huynguyen2311179-ui/STM32-PLC/01_Full_Design/Project Outputs for DA1_prj/DA1_prj.xlsx

Line # | Name | Description | Designator | Revision ID | Revision State | Revision Status | Quantity | Footprint | Manufacturer 1 | Manufacturer Part Number 1 | Manufacturer Lifecycle 1 | Supplier 1 | Supplier Part Number 1 | Supplier Unit Price 1 | Supplier Subtotal 1
 | 3002 | Battery Holder: SMT, 1 Coin Cell, 20mm, PhosBronze/Tin-Nickel | Keystone Electronics 3002 | BT1 |  | Not managed |  | 1 | BAT_3002
 | 100nF | Capacitor (Semiconductor SIM Model) | C1, C2, C4, C5, C7, C8, C25, C33, C34, C35, C36 |  | Not managed |  | 11 | FP-C0603C-CF-IPC_A
 | 4.7uF | Capacitor (Semiconductor SIM Model) | C3, C6, C9 |  | Not managed |  | 3 | FP-C0603C-CF-IPC_A
 | 1uF | Capacitor (Semiconductor SIM Model) | C10, C11, C15, C17, C19, C21, C23 |  | Not managed |  | 7 | FP-C0603C-CF-IPC_A
 | 10pF | Capacitor (Semiconductor SIM Model) | C12, C24 |  | Not managed |  | 2 | FP-C0603C-CF-IPC_A
 | 4,7pF | Capacitor (Semiconductor SIM Model) | C13, C26 |  | Not managed |  | 2 | FP-C0603C-CF-IPC_A
 | 10nF | Capacitor (Semiconductor SIM Model) | C14, C16, C18, C20, C22, C27, C28, C29, C30, C31, C32 |  | Not managed |  | 11 | FP-C0603C-CF-IPC_A
 | PESD5V0L2BT,215 |  | D1 |  | Not managed |  | 1 | SOT95P230X110-3N
 | BZX84C3V6LT1G |  | D2, D3, D4, D5, D6, D7, D8, D9, D10, D11, D12, D13, D14, D15, D16, D17, D18, D19, D20, D21, D22, D23 |  | Not managed |  | 22 | SOT95P240X111-3N
 | B560C-13-F | Diode Schottky 60 V 5A Surface Mount SMC | D24 |  | Not managed |  | 1 | SMC
 | LED_USB_RX_TX | 430mcd Colorless transparence 520nm Emerald 140° LED0603 Light Emitting Diodes (LED) ROHS | D25 |  | Not managed |  | 1 | WL-SMCW_0603_150060xx75000
 | LED_CAN_RX_TX | 430mcd Colorless transparence 520nm Emerald 140° LED0603 Light Emitting Diodes (LED) ROHS | D26 |  | Not managed |  | 1 | WL-SMCW_0603_150060xx75000
 | LED_ERROR | 430mcd Colorless transparence 520nm Emerald 140° LED0603 Light Emitting Diodes (LED) ROHS | D27 |  | Not managed |  | 1 | WL-SMCW_0603_150060xx75000
 | 0ZCH0150FF2E | 1210 SMT PPTC | 1.50 Ih | 6V | F1, F2, F3, F4, F5, F6, F7, F8, F9, F10, F11, F12, F13, F14, F15, F16, F17, F18, F19, F20, F21, F22, F23, F24, F25, F26, F27, F28, F29, F30 |  | Not managed |  | 30 | FUSC3225X90N
 | MountingHole_Pad |  | H1, H2, H3, H4 |  | Not managed |  | 4 | MountingHole_2.7mm_M2.5_DIN965_Pad
 | JP8 | Connector 8 | JP1 |  | Not managed |  | 1 | HDR/Header/8
 | Screw_terminal 1x6 | Header, 6-Pin | P1 |  | Not managed |  | 1 | HDR/Terminal/6
 | _x0016_Screw_terminal 1x6 | Header, 6-Pin | P2, P3, P6, P7, P8, P11 |  | Not managed |  | 6 | HDR/Terminal/6
 | _x0016_Screw_terminal 1x3 | Header, 3-Pin | P4 |  | Not managed |  | 1 | HDR/Terminal/3
 | _x0016_Screw_terminal 1x4 | Header, 4-Pin | P5, P10 |  | Not managed |  | 2 | HDR/Terminal/4
 | _x0016_Screw_terminal 1x2 | Header, 2-Pin | P9, P12 |  | Not managed |  | 2 | HDR/Terminal/2
 | BUK9M15-60EX | Bá»™ chuyá»ƒn Ä‘á»•i N-Channel 60 V 47A (Tc) 75W (Tc) gáº¯n bá» máº·t LFPAK33 | Q1, Q2, Q3, Q4, Q5, Q6, Q7, Q8 |  | Not managed |  | 8 | TRANS_BUK9M15-60EX
 | BC847C-QR |  | Q9, Q10, Q11 |  | Not managed |  | 3 | SOT95P240X111-3N
 | 1,5k | RES | R1 |  | Not managed |  | 1 | tro smd 0603
 | 2k | RES | R2 |  | Not managed |  | 1 | tro smd 0603
 | 0 | RES | R3, R5 |  | Not managed |  | 2 | tro smd 0603
 | 60 | RES | R4, R6 |  | Not managed |  | 2 | tro smd 0603
 | 1k | RES | R7, R8, R9, R10, R11, R12, R13, R14, R15, R16, R17, R18, R19, R20, R21, R22, R23, R24, R25, R26, R63, R64, R65, R66, R67, R68, R69, R70, R71, R72, R73, R74, R75, R76, R77, R78, R79, R80, R81, R82 |  | Not managed |  | 40 | tro smd 0603
 | 160 | RES | R27, R28, R29, R33, R34, R35, R39, R40, R43, R44, R45, R46, R47, R48, R49, R50, R51, R52, R53, R54, R55, R56, R57, R58, R59, R60, R61, R62, R83, R84, R85, R86, R87, R88, R89, R90, R91, R92, R93, R94, R95, R96, R97, R98, R99, R100, R101, R102, R103, R104, R105, R106, R109, R110, R118 |  | Not managed |  | 55 | tro smd 0603
 | 10k | RES | R30, R31, R32, R36, R37, R38, R41, R42, R107, R108, R111, R112, R113, R114, R115, R116, R117, R119, R120, R121 |  | Not managed |  | 20 | tro smd 0603
 | 220 | RES | R122, R123, R124 |  | Not managed |  | 3 | tro smd 0603
 | ST-Link V2 connector | Header, 6-Pin | STLINK2 |  | Not managed |  | 1 | HDR/Header/6
 | SW | Switch button 2 pin | SW1 |  | Not managed |  | 1 | SW1-SMD
 | 4-5435640-1 | SWITCH ROCKER DIP SPST 60MA 5V | SW2 |  | Unknown server |  | 1 | FP-4-5435640-1-MFG
 | MIC5504-3.3YM5_TR | Linear Voltage Regulator IC Positive Fixed 1 Output 300mA SOT-23-5 | U1 |  | Not managed |  | 1 | SOT95P280X145-5N
 | STM32F373VBTx |  | U2 |  | Not managed |  | 1 | QFP50P1600X1600X160-100N
 | TCAN332D | 3.3-V CAN Transceivers | U3 |  | Not managed |  | 1 | SOIC127P599X175-8N
 | PC817X3NSZ1B | Optoisolator Transistor Output - 1 Channel 4-DIP | U4, U5, U6, U7, U8, U9, U10, U11, U12, U13, U14, U15, U16, U17, U18, U19, U20, U21, U22, U23 |  | Not managed |  | 20 | DIP762W50P254L495H455Q4
 | LM324AM | Low power general-purpose quad operational amplifier 14-SOIC 0 to 70 | U24 |  | Not managed |  | 1 | SOIC127P600X175-14N
 | LM2904DR | Dual, 26-V, 700-kHz operational amplifier | U25 |  | Not managed |  | 1 | SOIC127P599X175-8N
 | SN74HC14N | Hex Schmitt-Trigger Inverters, N0014A, TUBE | U26, U27 |  | Unknown server |  | 2 | N0014A
 | USB-B1HSB6 | USB-B (USB TYPE-B) - Receptacle Connector 4 Position Through Hole, Right Angle | X1 |  | Not managed |  | 1 | OST_USB-B1HSB6
 | HSE | Crystal For all Crystal 2pin. | X2 |  | Not managed |  | 1 | XT3
 | LSE | 32.768 kHz Â±20ppm Crystal 7pF 70 kOhms 2-SMD, No Lead | Y1 |  | Not managed |  | 1 | XTAL_ECS-.327-7-34B-TR
