huynguyen2311179-ui/STM32-PLC/01_Full_Design/DA1_prj.pdf

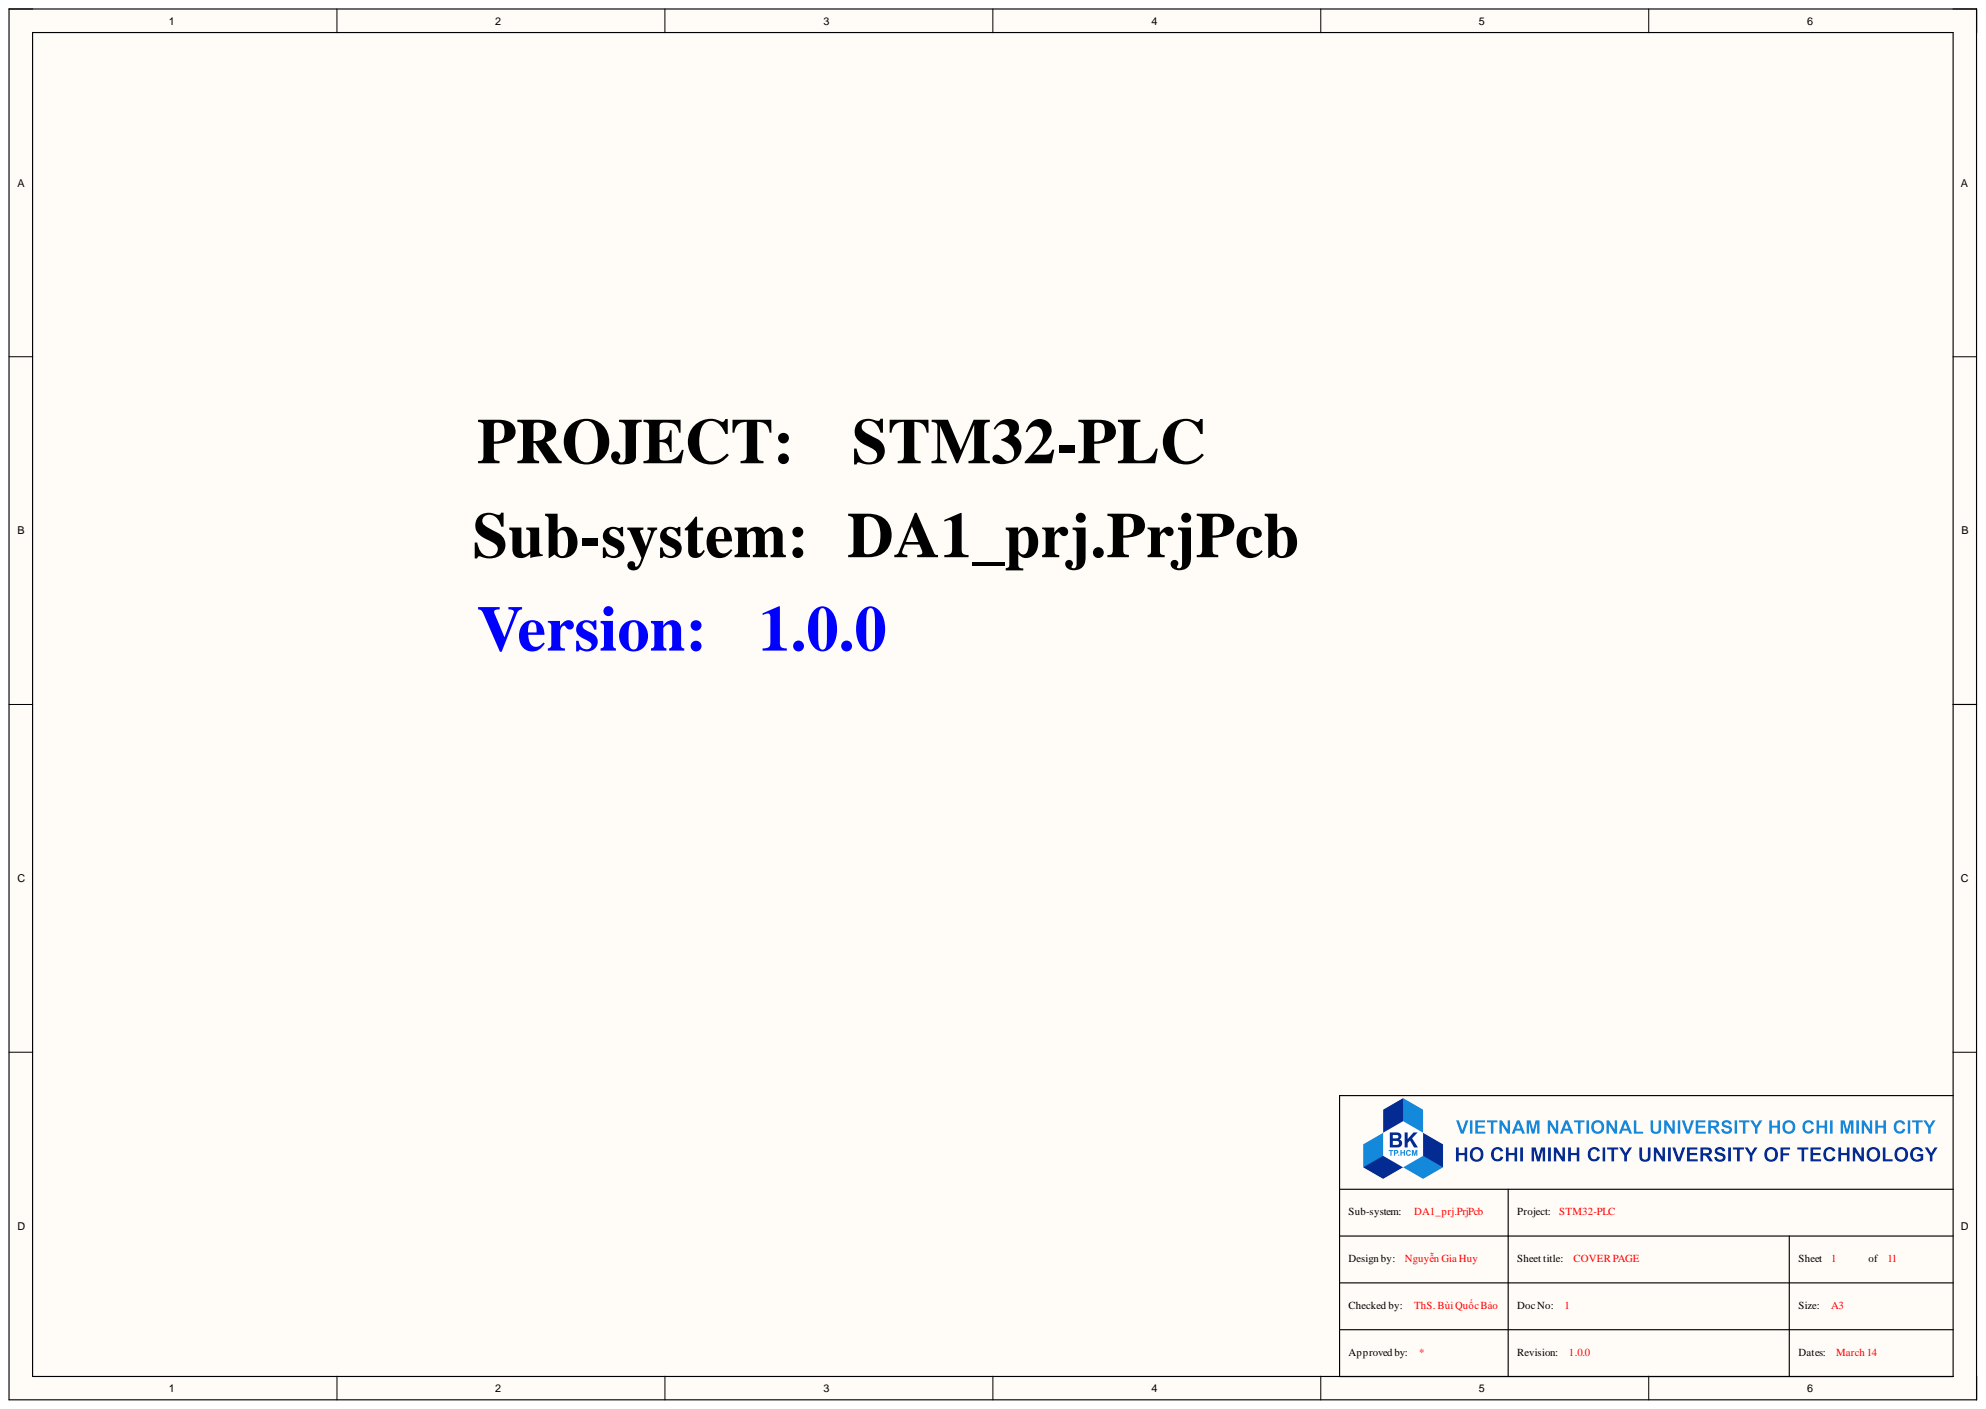
[picture p37: page 1]

Sub-system: DA1_prj.PrjPcb | Project: STM32-PLC

Design by: Nguyễn Gia Huy | Sheet title: COVER PAGE | Sheet 1 of 11

ThS. BùiQuốcBảo Checked by: | DocNo: | Size: A3

Approved by: * | Revision: 1.0.0 | Dates: March 14

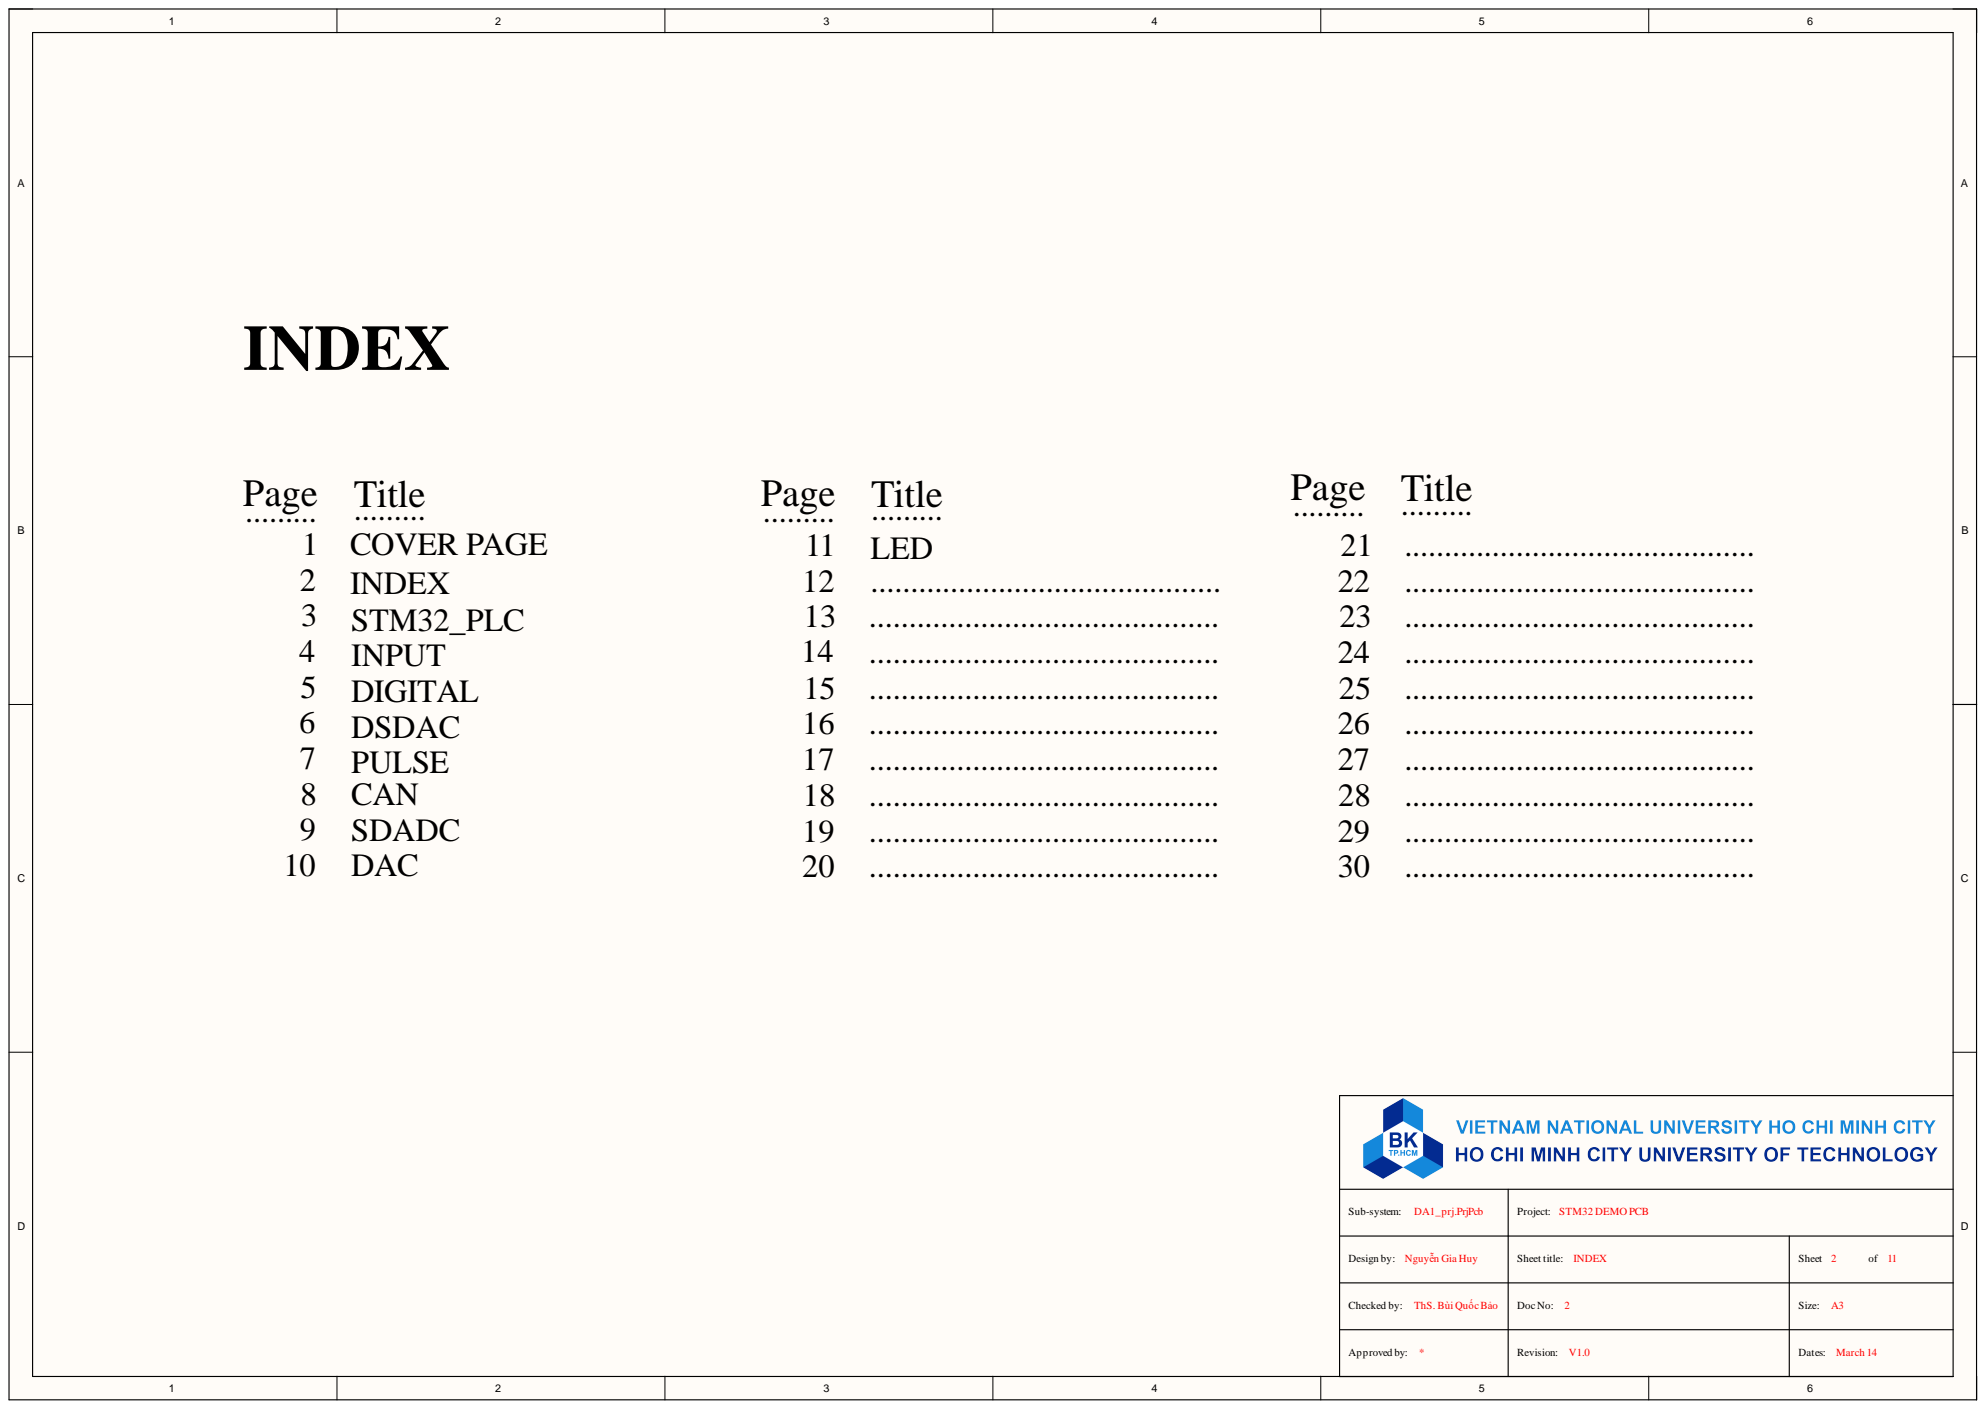
[picture p38: page 2]

Sub-system: DA1_prj.PrjPcb | Project: STM32 DEMO PCB

Design by: Nguyễn Gia Huy | Sheet title: INDEX | Sheet 2 of 11

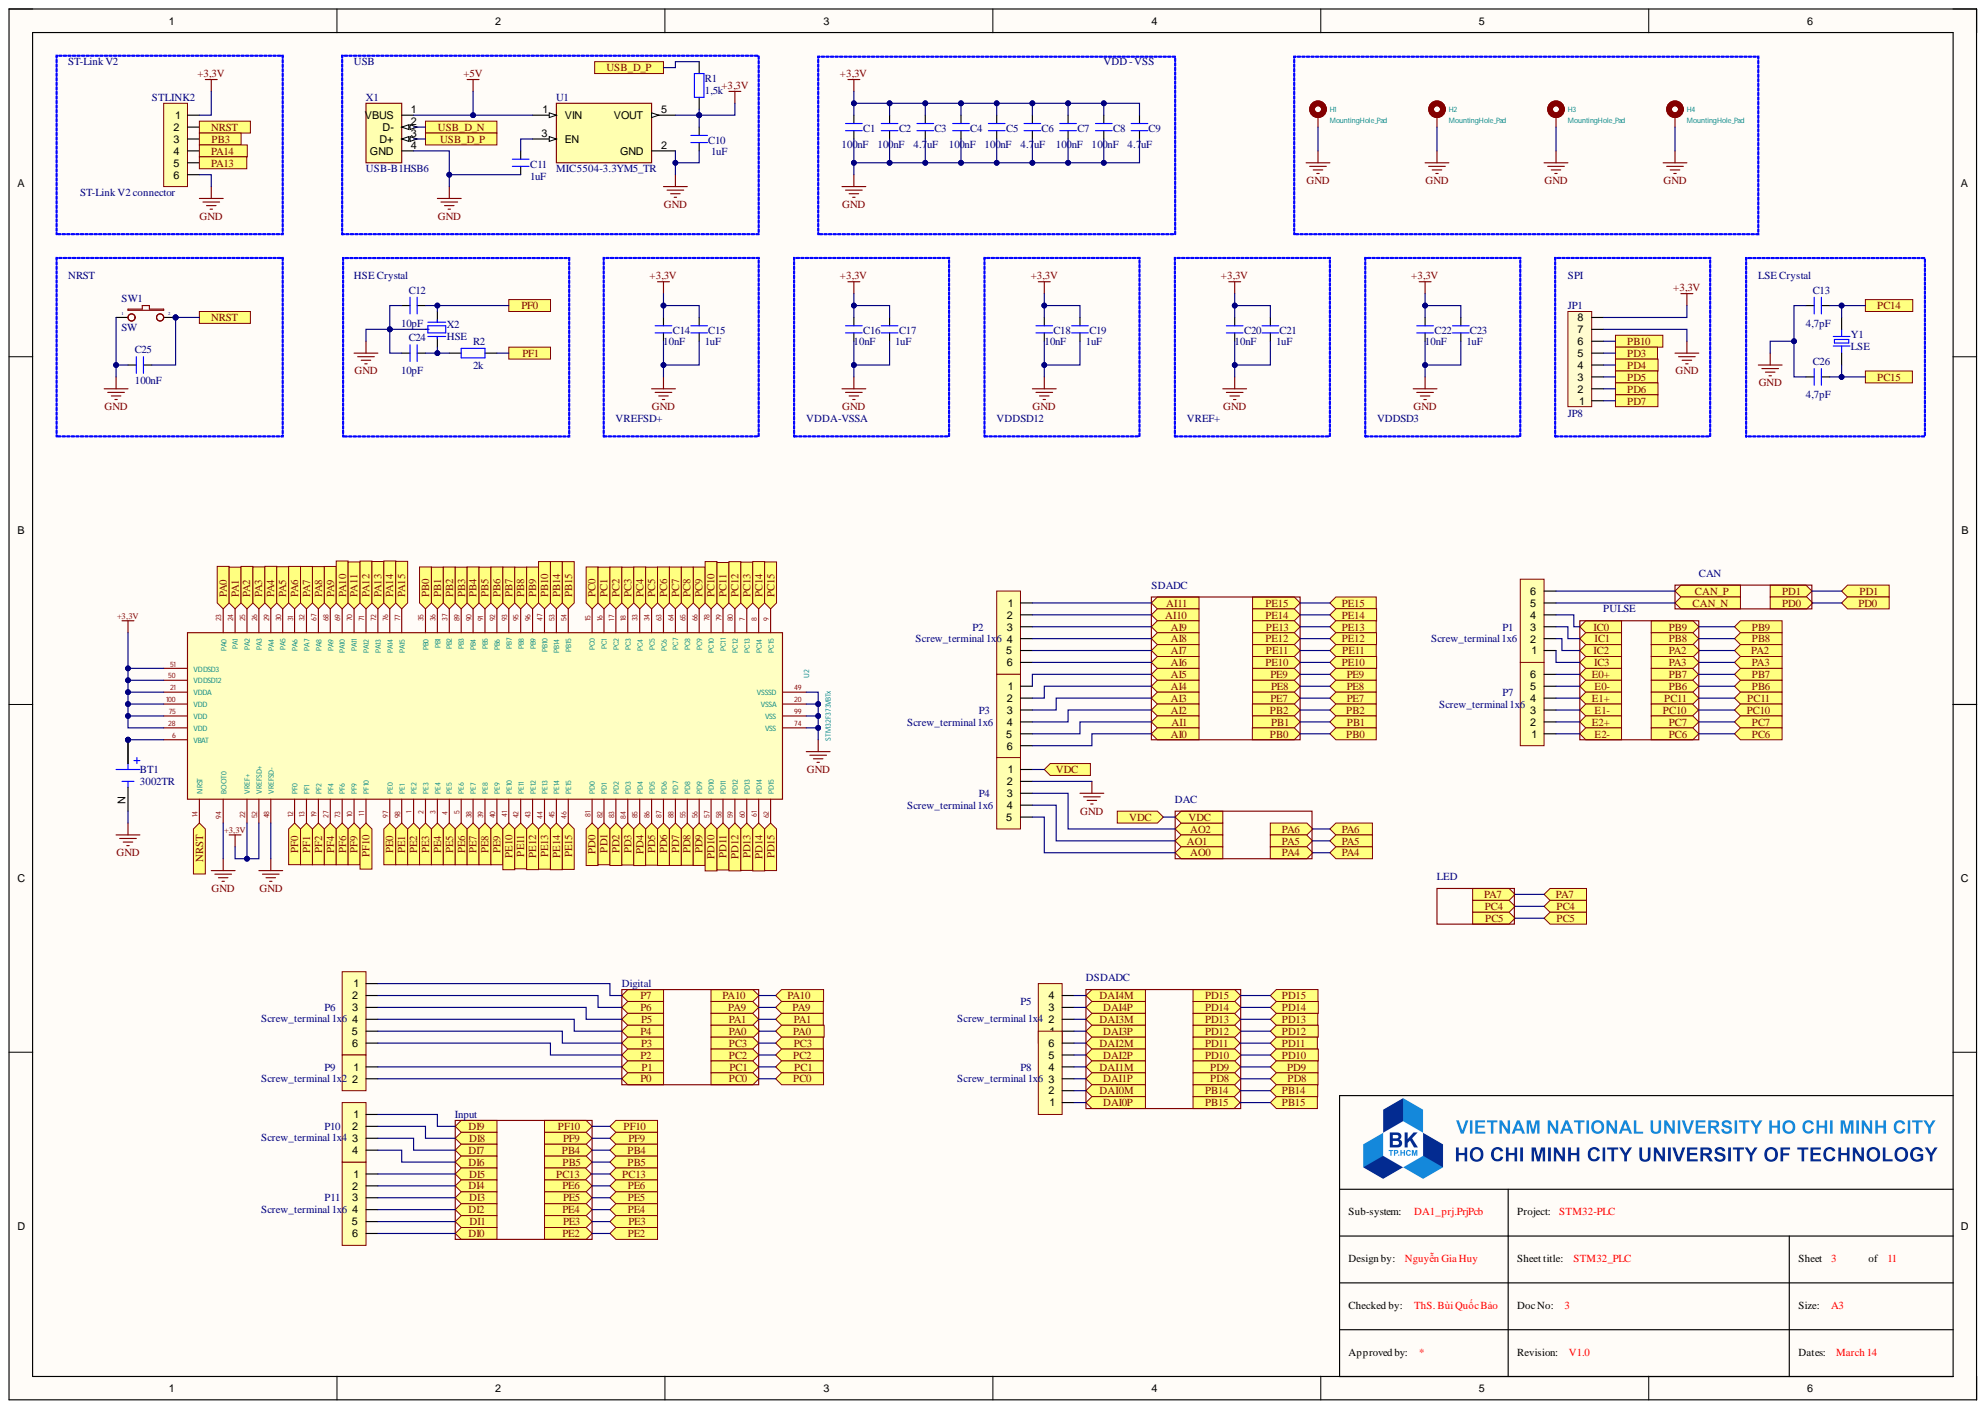
[picture p39: page 3]

VDC | VDC GND AO2 PA6 AO1 PA5 AO0 PA4

5 4 3 2 1

Sub-system: DA1_prj.PrjPcb | Project: STM32-PLC

Design by: Nguyễn Gia Huy | Sheet title: STM32_PLC | Sheet 3 of 11

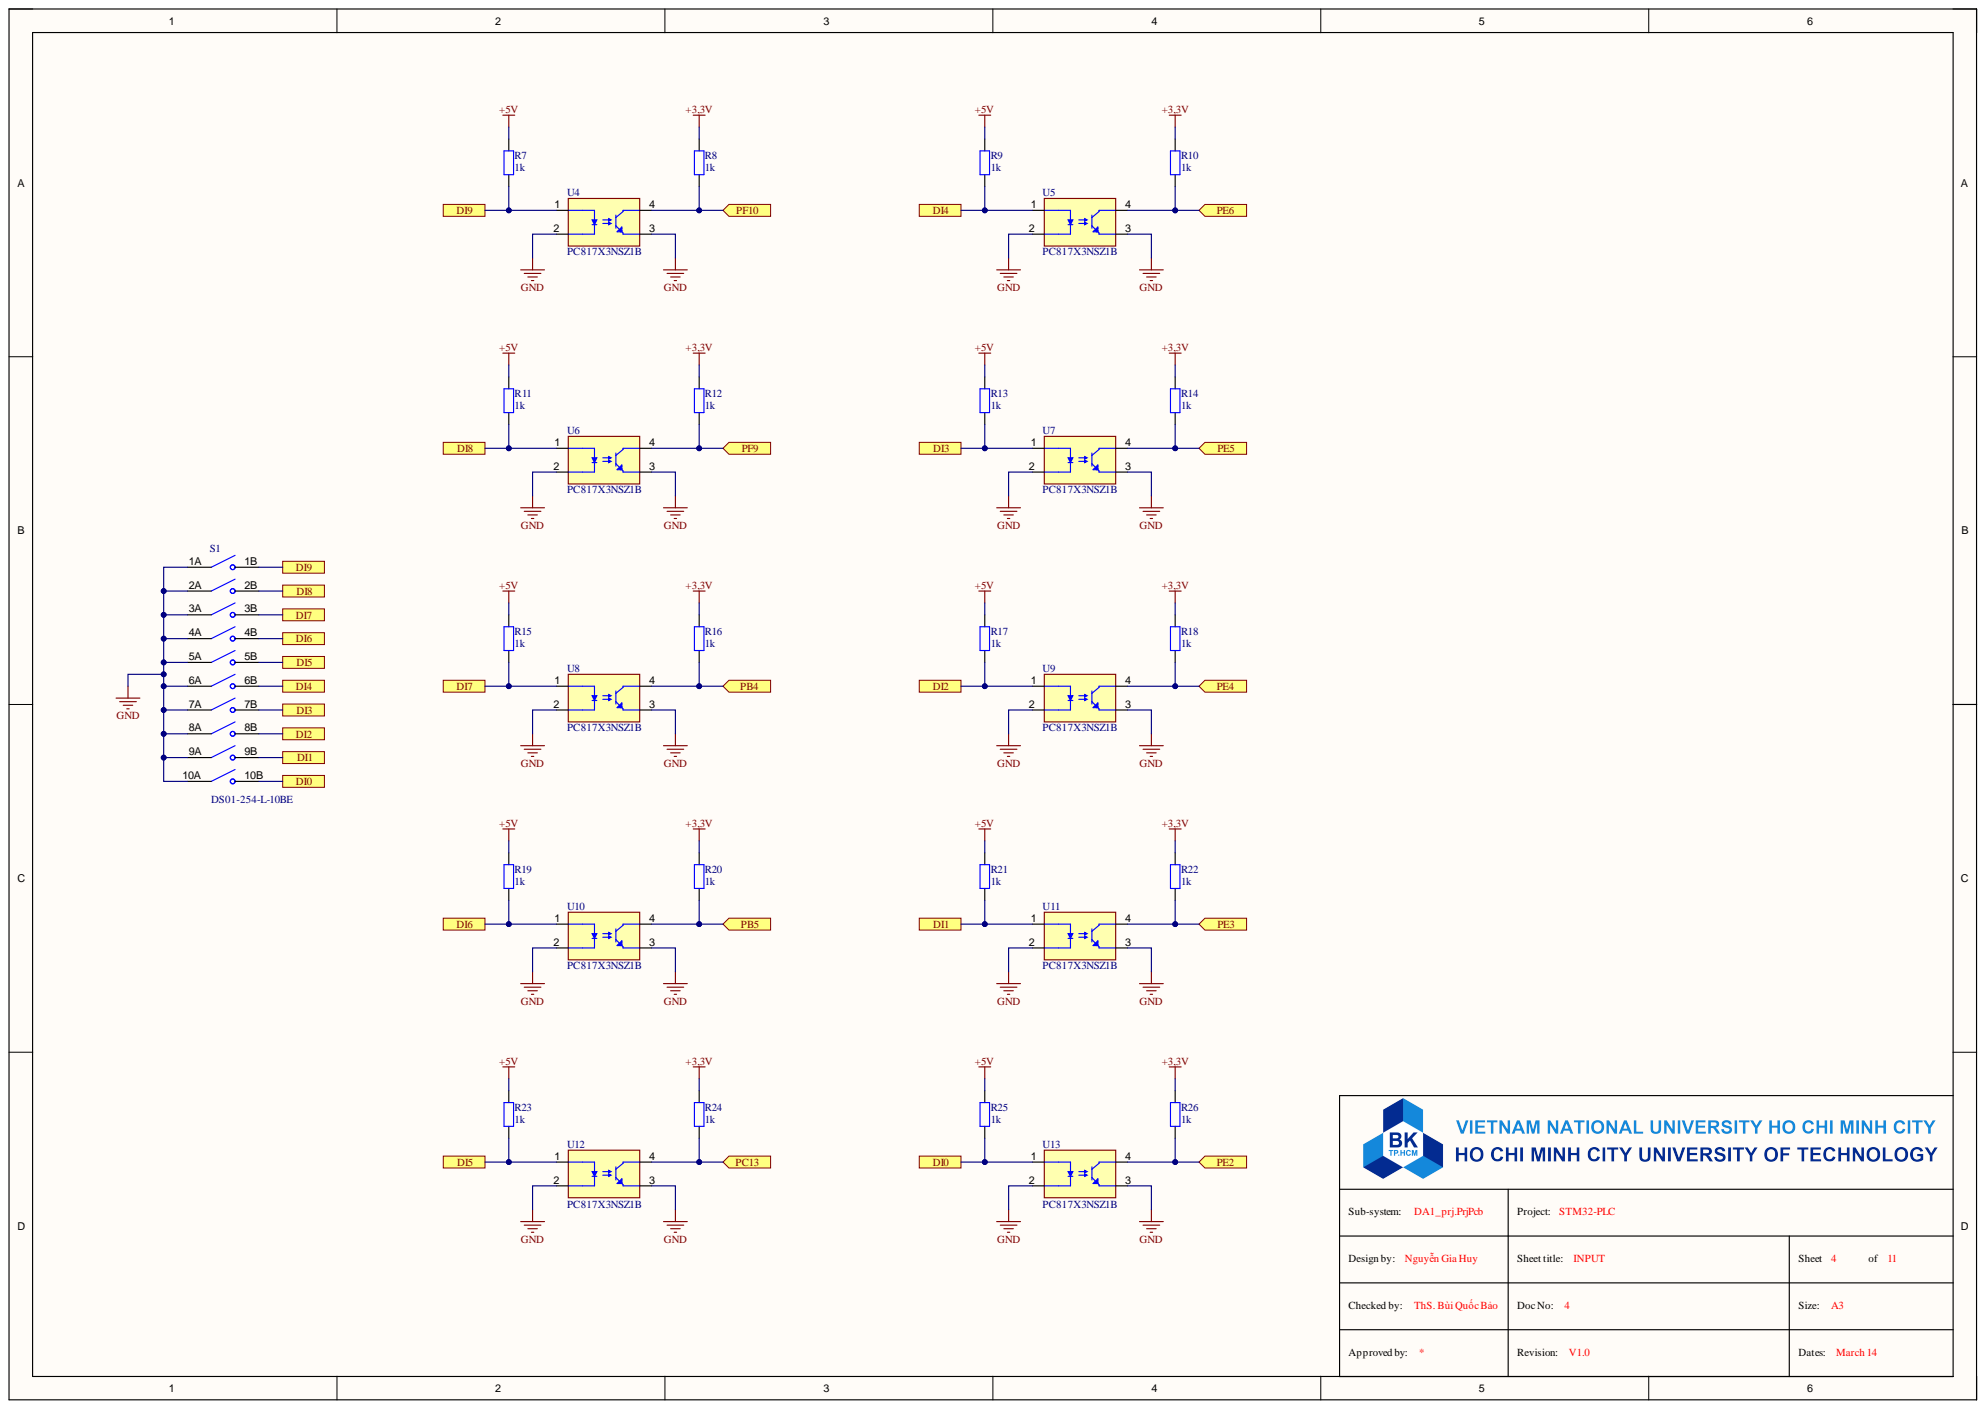
[picture p40: page 4]

Sub-system: DA1_prj.PrjPcb | Project: STM32-PLC

Design by: Nguyễn Gia Huy | Sheet title: INPUT | Sheet 4 of 11

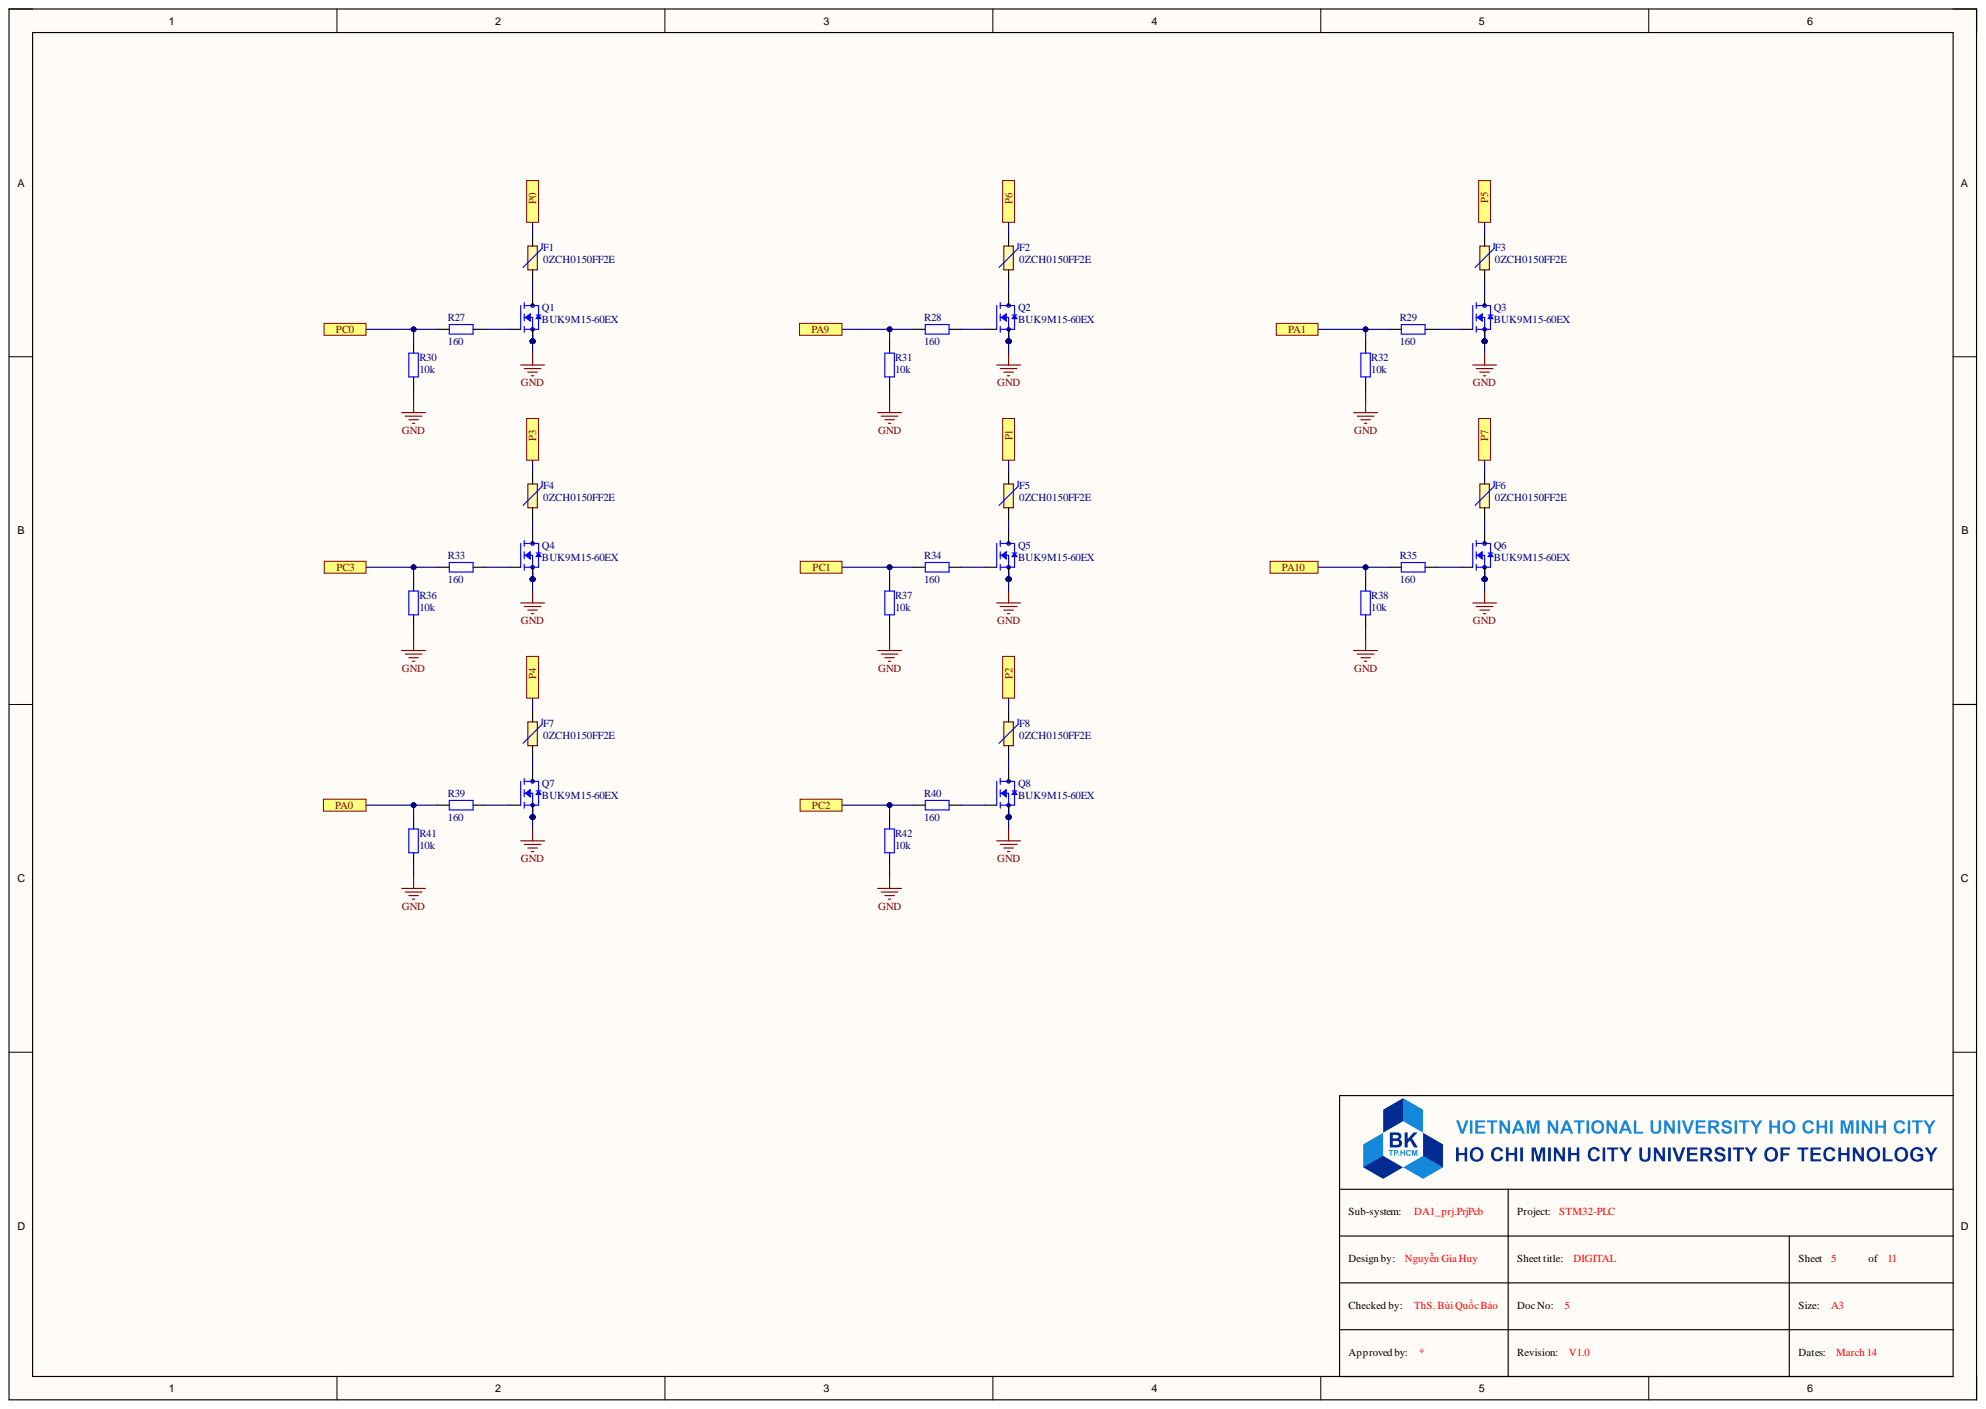
[picture p41: page 5]

S u b -s y s t em : D A 1 _ p rj . Prj P cb | P r oj e c t : S TM3 2 -PLC

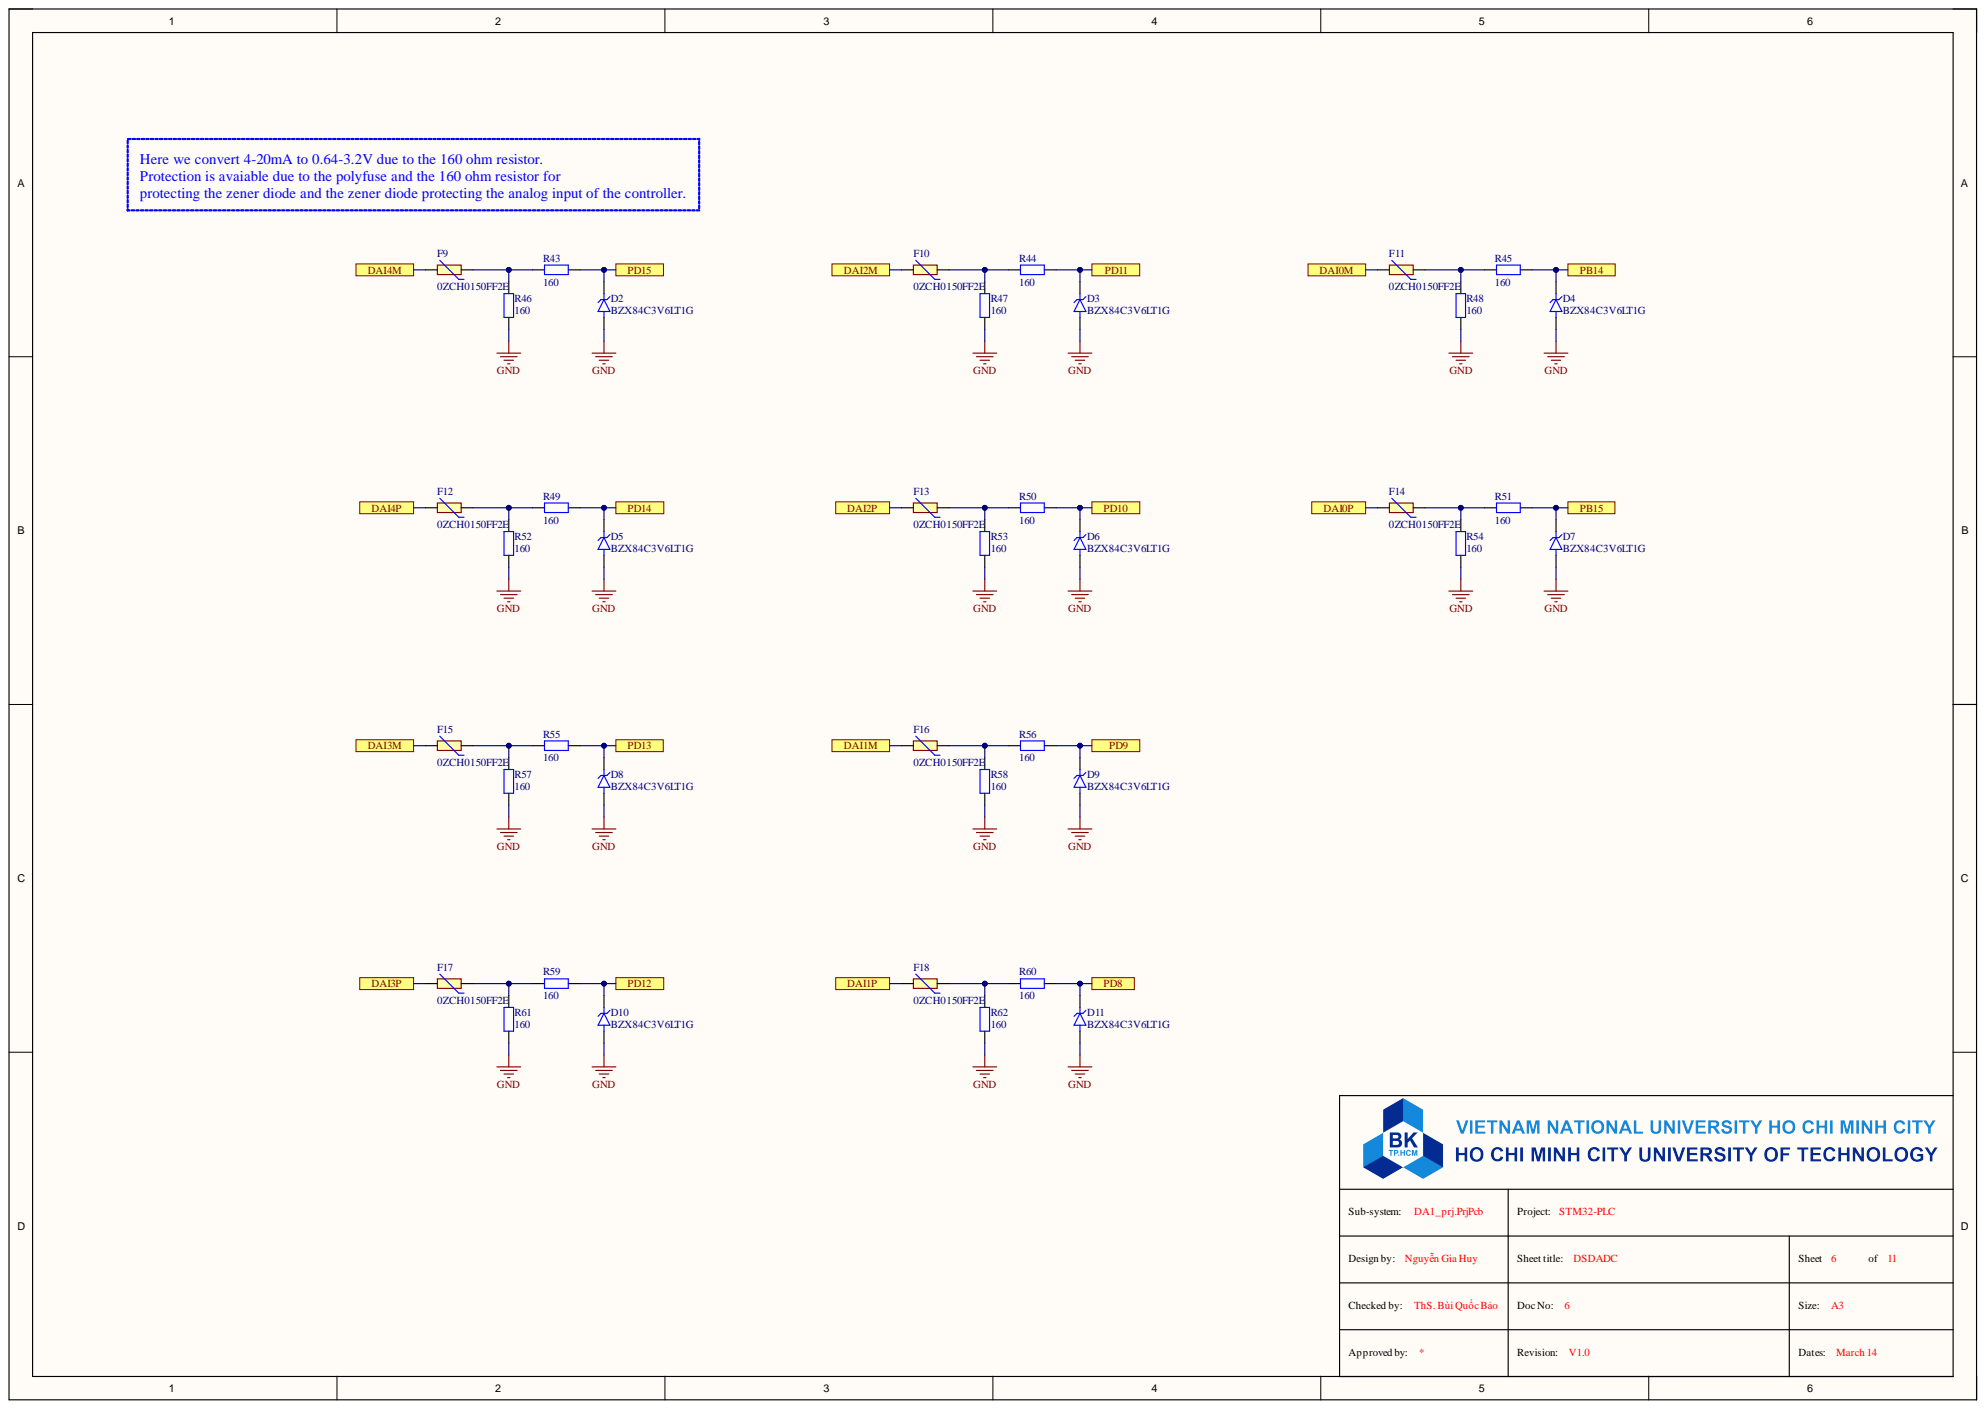
[picture p42: page 6]

Here we convert 4-20mA to 0.64-3.2V due to the 160 ohm resistor.
Protection is avaiable due to the polyfuse and the 160 ohm resistor for
protecting the zener diode and the zener diode protecting the analog input of the controller.

Sub-system: DA1_prj.PrjPcb | Project: STM32-PLC

Design by: Nguyễn Gia Huy | Sheet title: DSDADC | Sheet 6 of 11

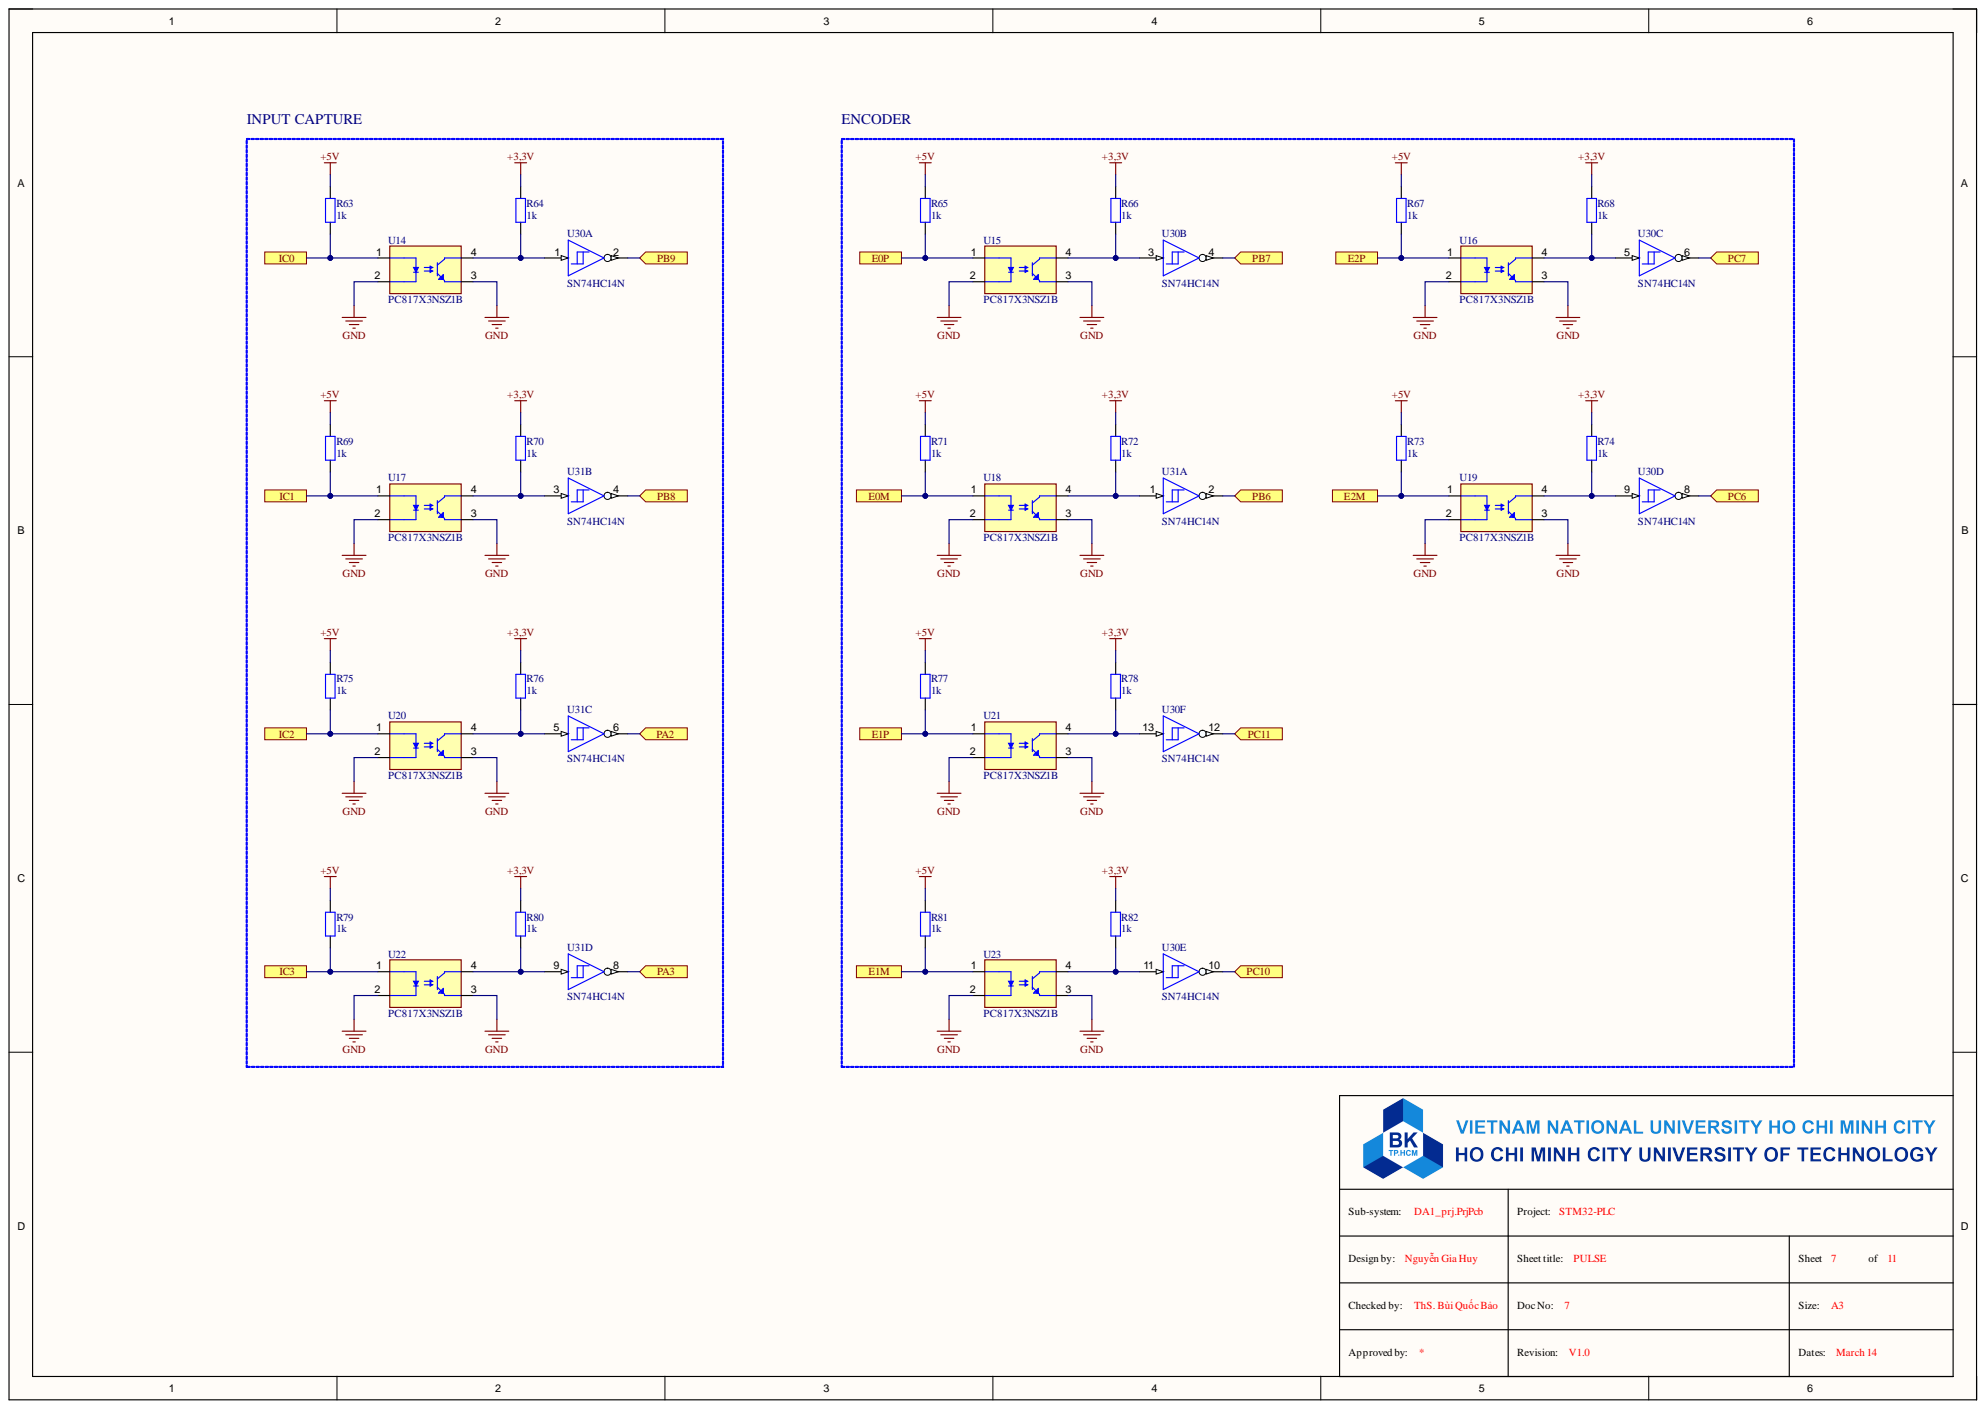
[picture p43: page 7]

Sub-system: DA1_prj.PrjPcb | Project: STM32-PLC

Design by: Nguyễn Gia Huy | Sheet title: PULSE | Sheet 7 of 11

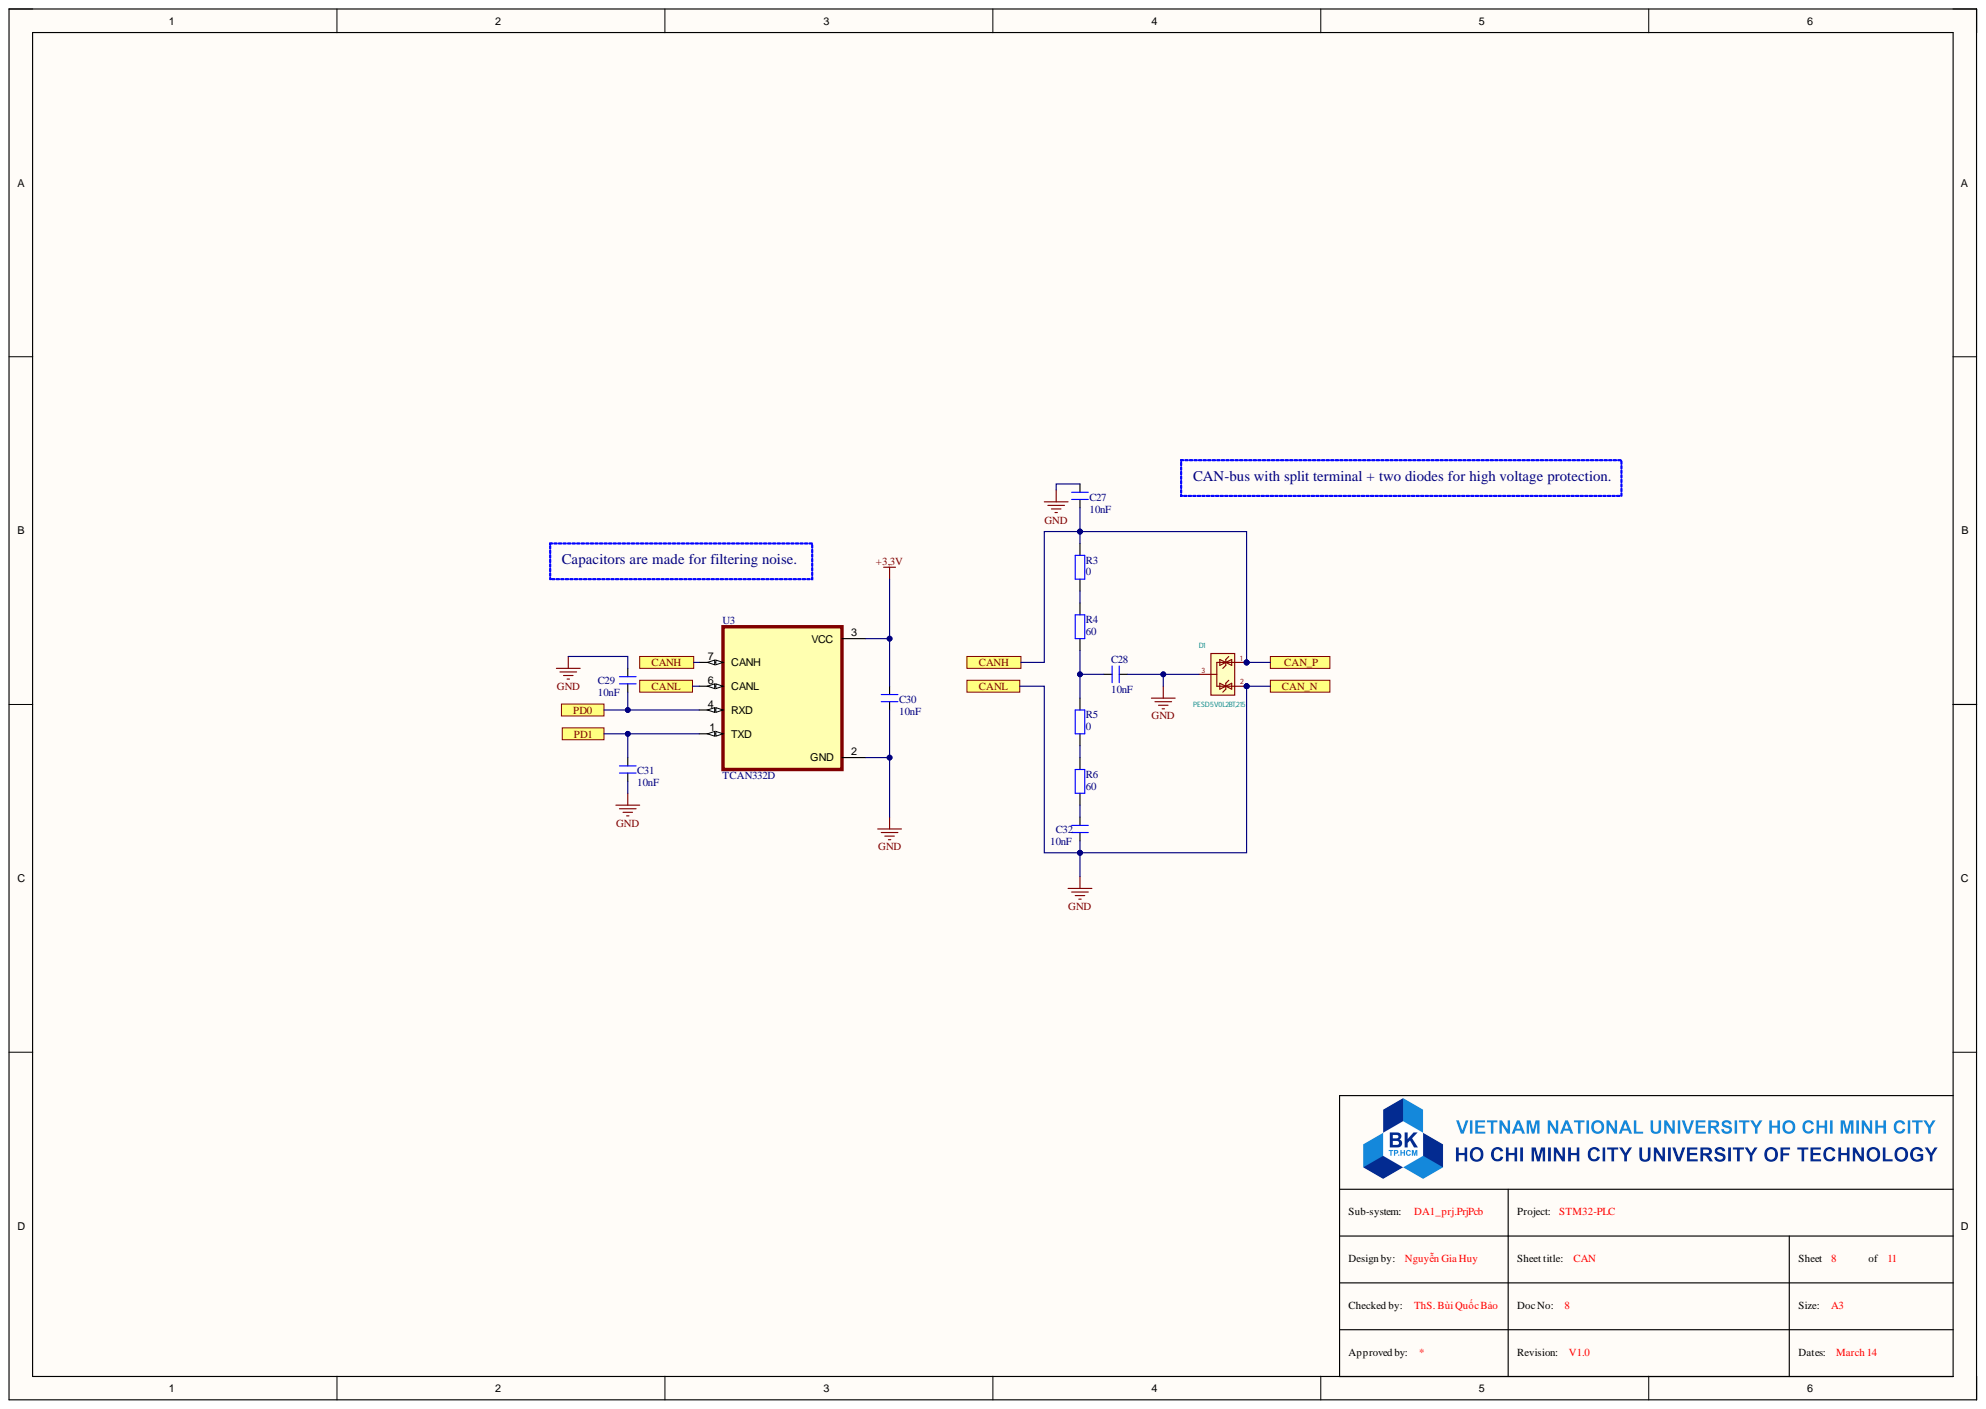
[picture p44: page 8]

CAN-bus with split te

for high voltage prote

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

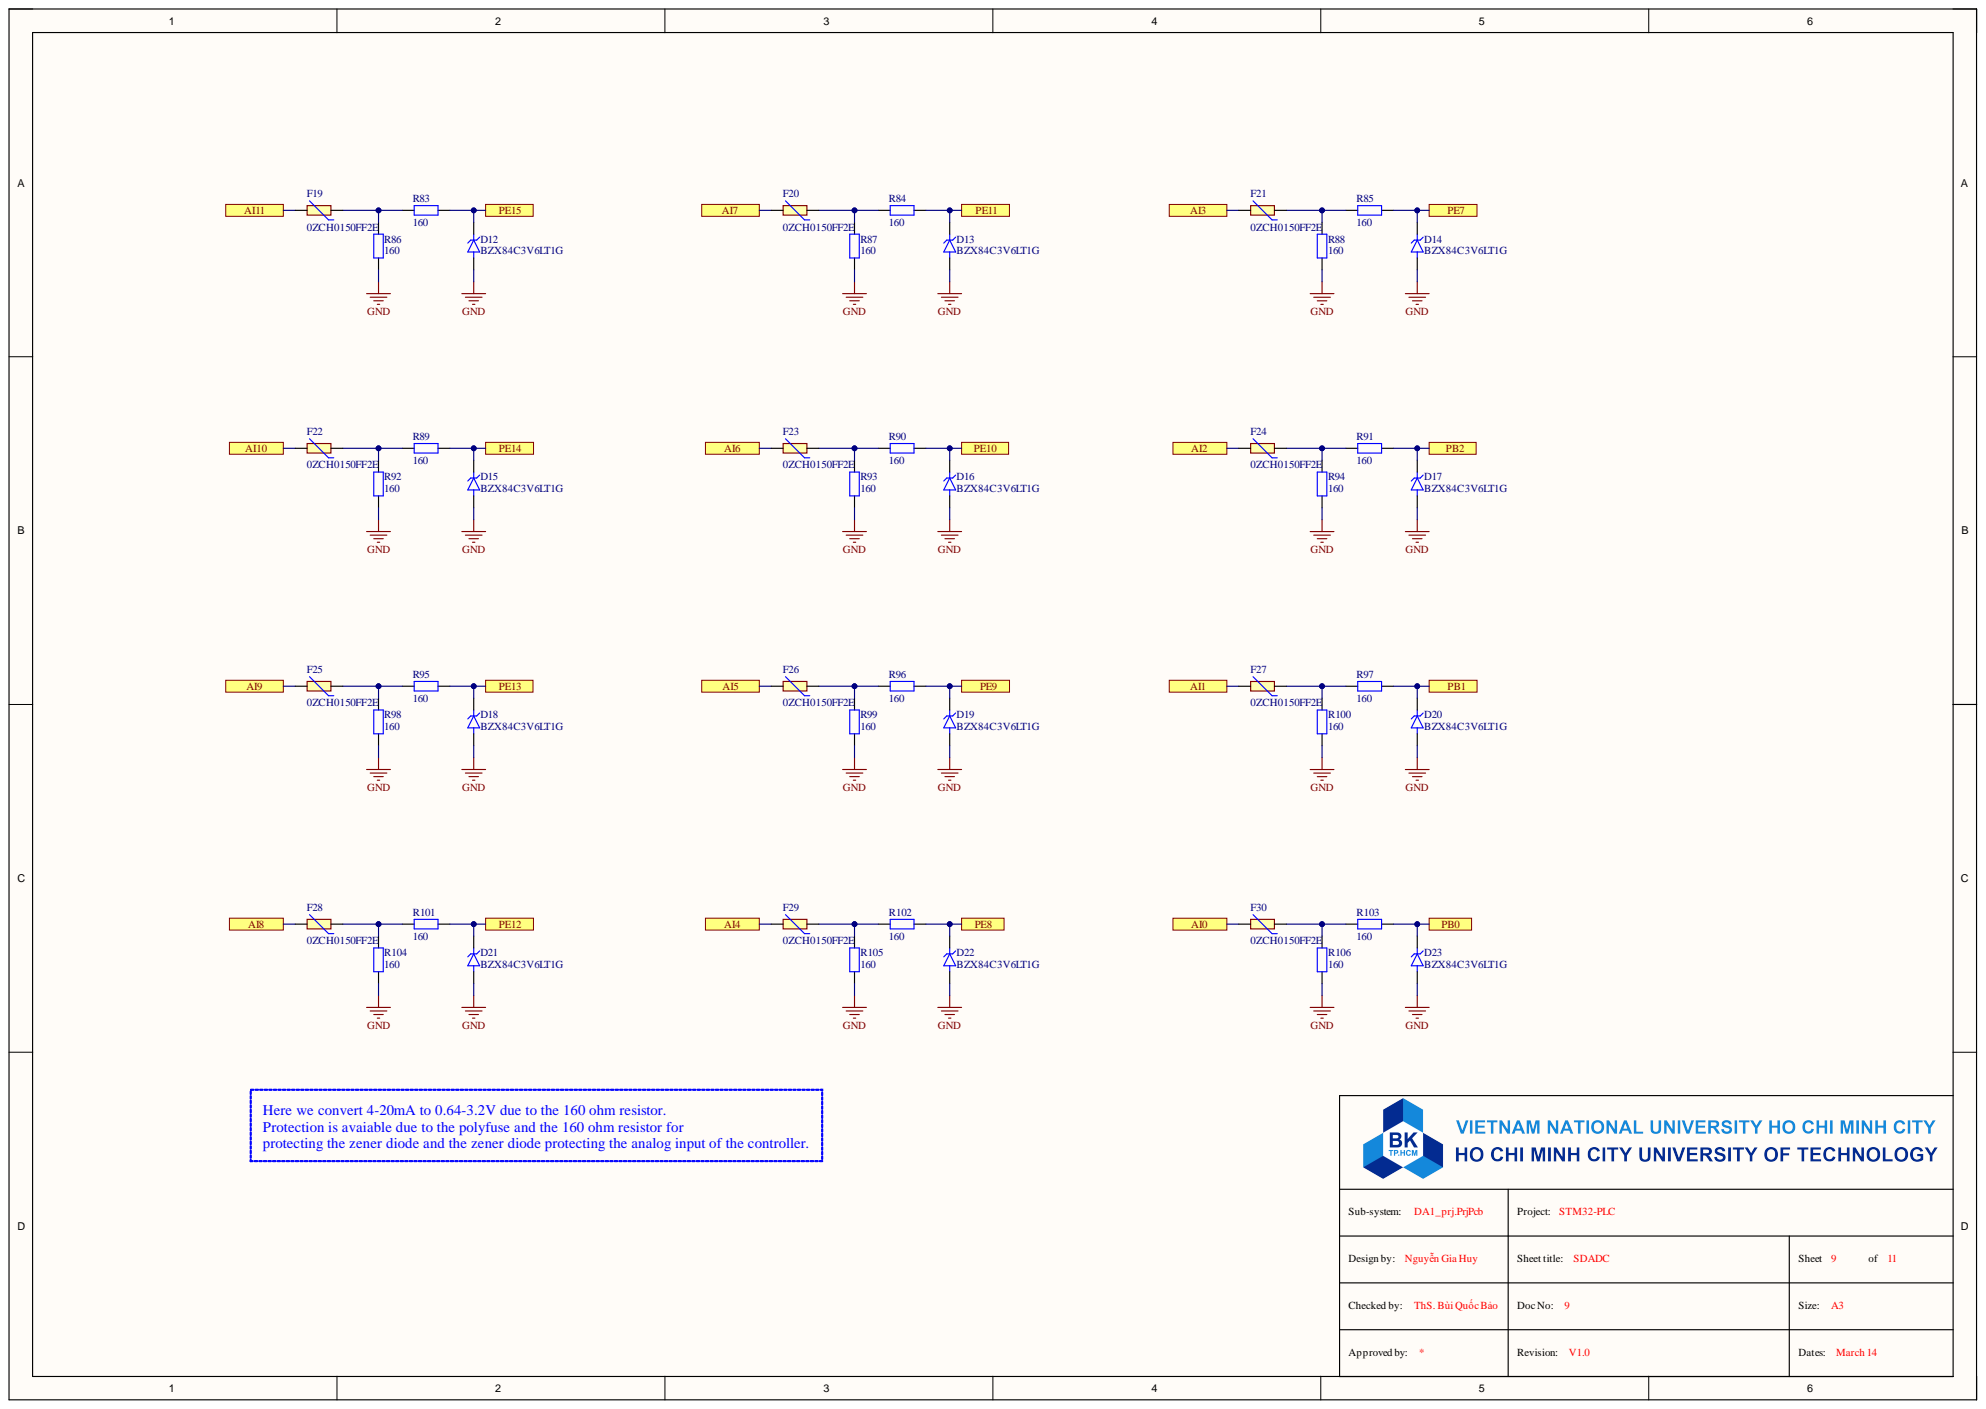
[picture p45: page 9]
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

Sub-system: DA1_prj.PrjPcb | Project: STM32-PLC

Design by: Nguyễn Gia Huy | Sheet title: SDADC | Sheet 9 of 11

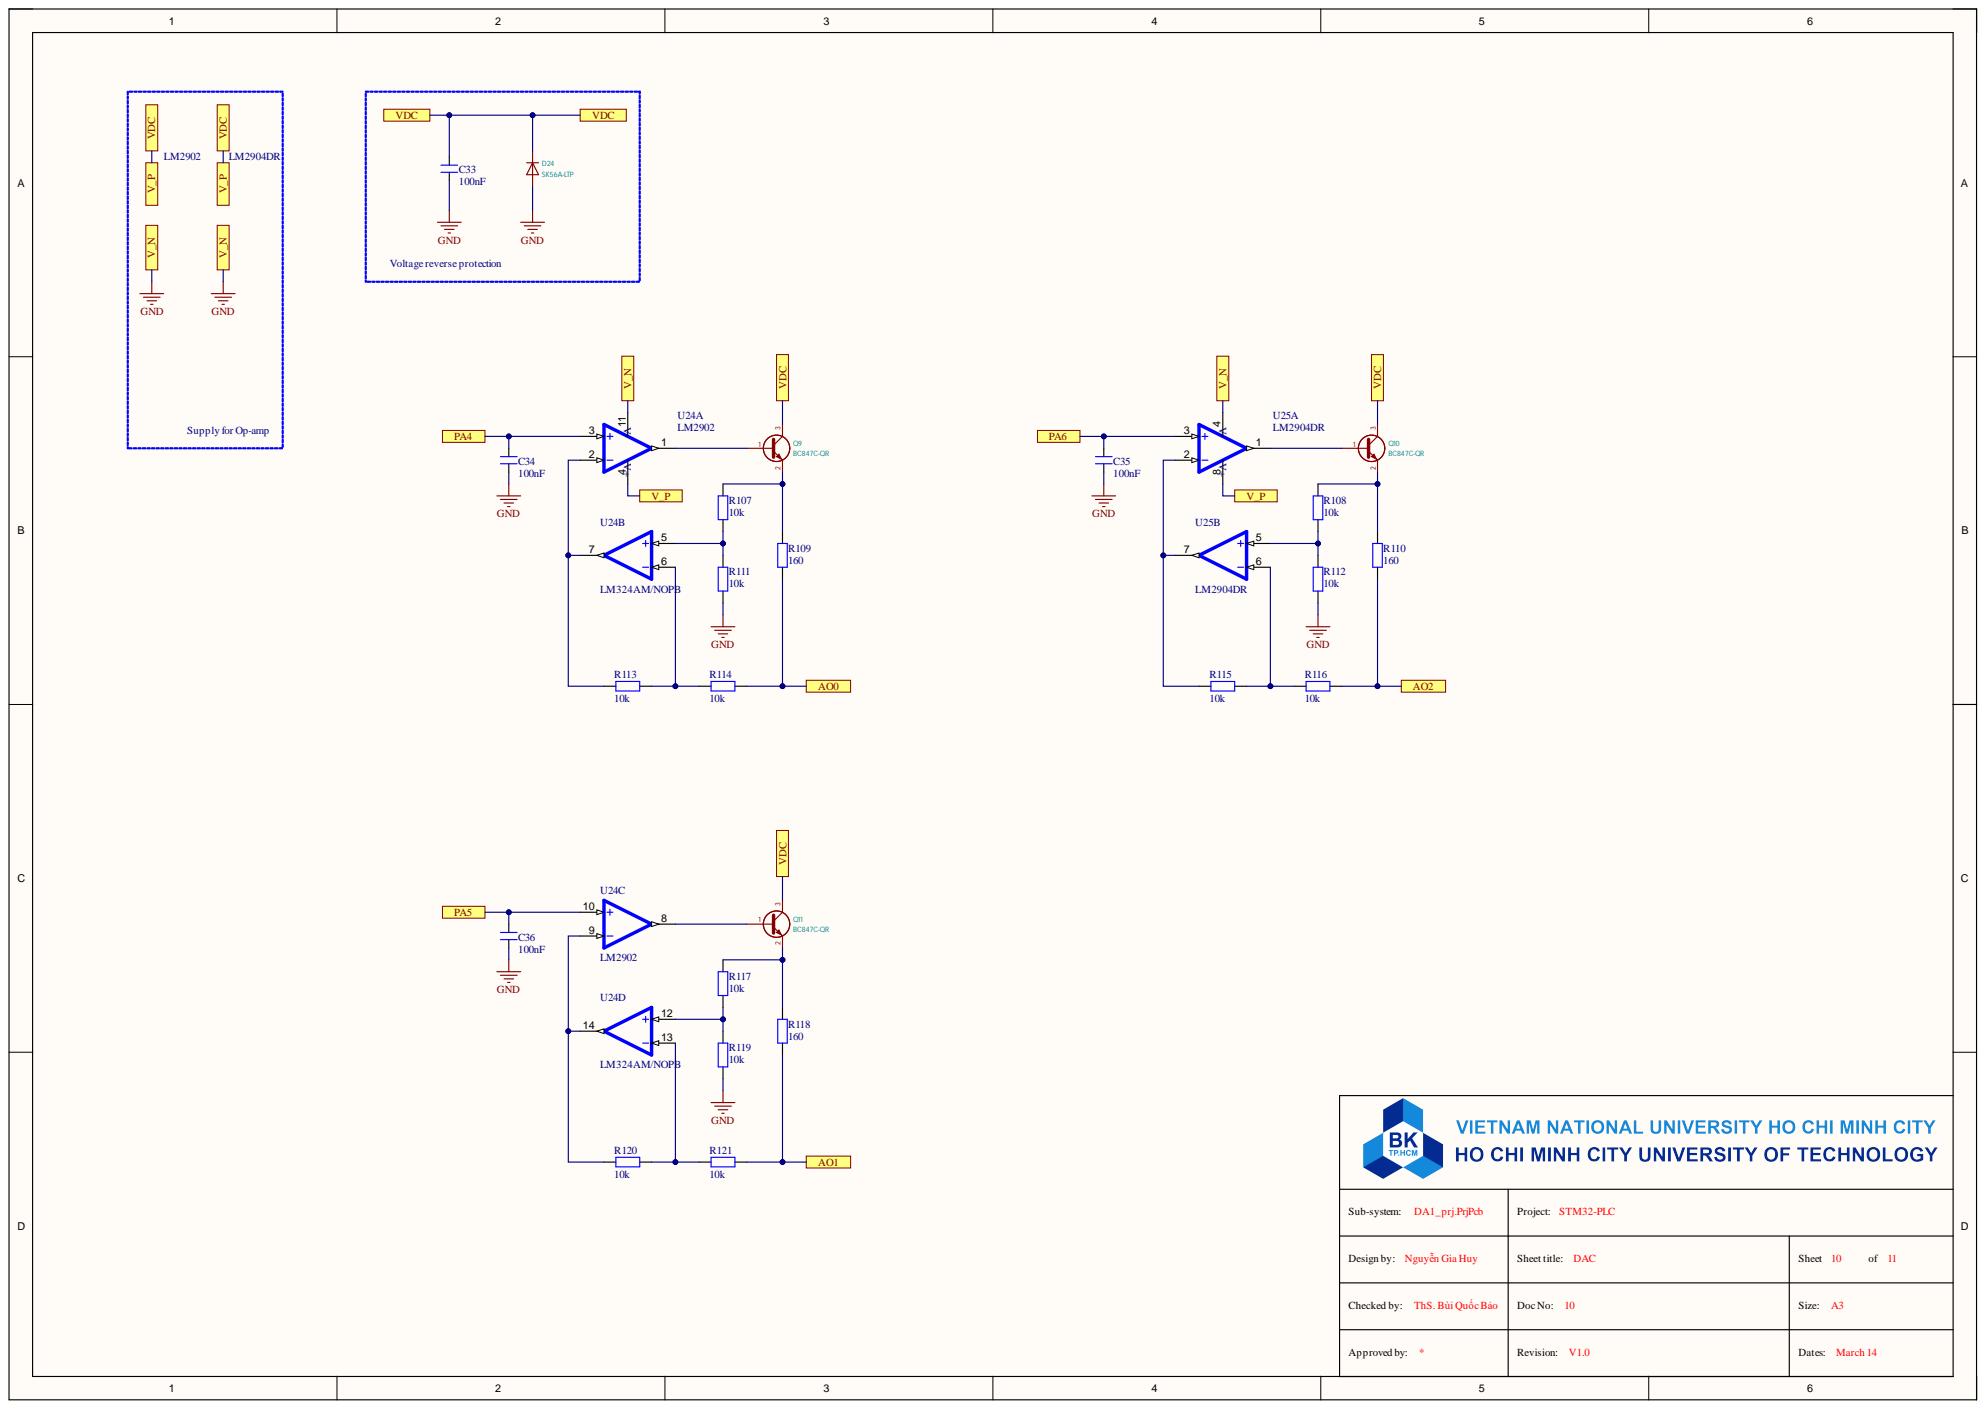
[picture p46: page 10]

Supply for Op-amp

Sub-system: DA1_prj.PrjPcb | Project: STM32-PLC

Design by: Nguyễn Gia Huy | Sheet title: DAC | Sheet 10 of 11

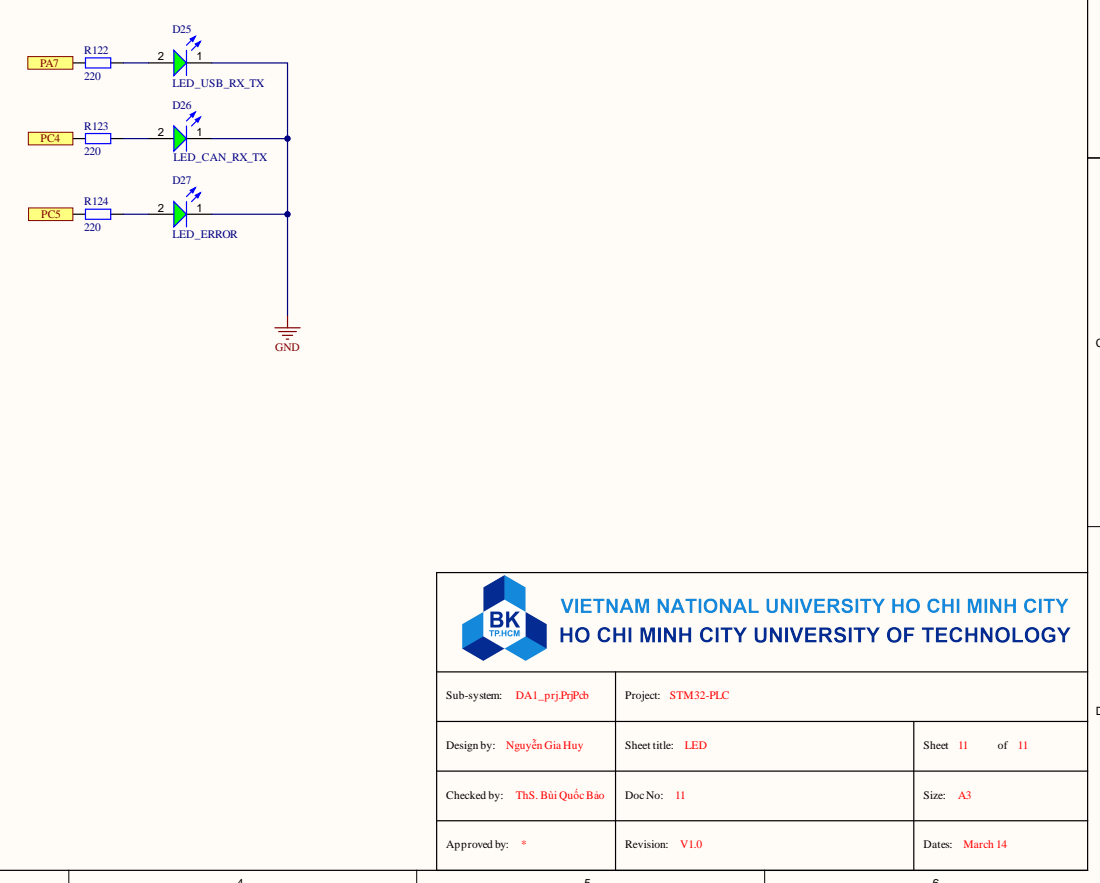
[picture p47: page 11]

Sub-system: DA1_prj.PrjPcb | Project: STM32-PLC

Design by: Nguyễn Gia Huy | Sheet title: LED | Sheet 11 of 11

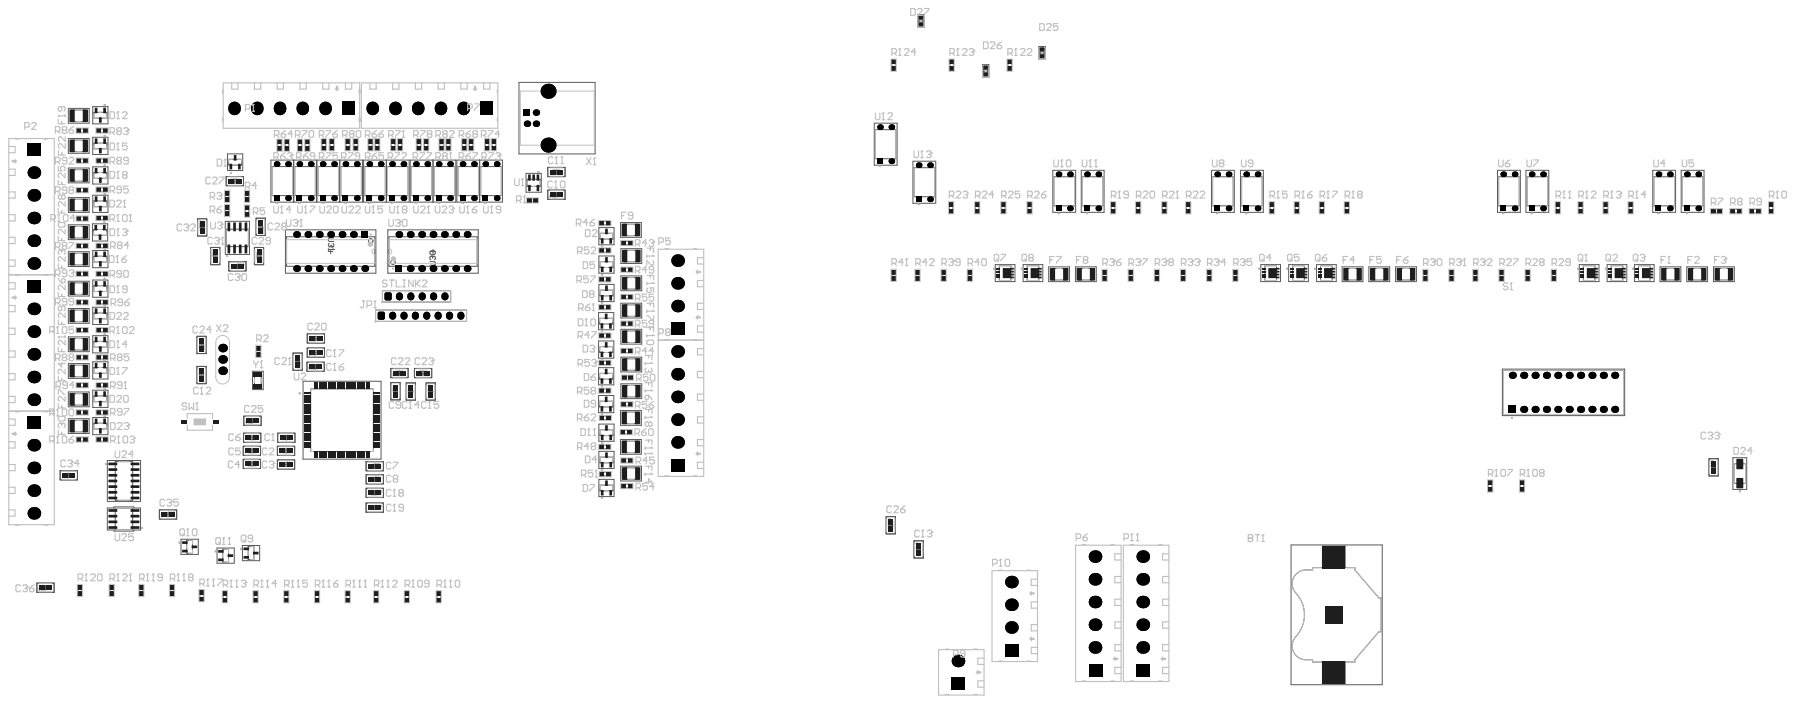
[picture p48: page 12]

100nF | Capacitor (Semiconductor SIMModel) | C1 | 1 FP-C0603C-CF-IPC_A

100nF | Capacitor (Semiconductor SIMModel) | C2 | 1 FP-C0603C-CF-IPC_A

4.7uF | Capacitor (Semiconductor SIMModel) | C3 | 1 FP-C0603C-CF-IPC_A

100nF | Capacitor (Semiconductor SIMModel) | C4 | 1 FP-C0603C-CF-IPC_A

100nF | Capacitor (Semiconductor SIMModel) | C5 | 1 FP-C0603C-CF-IPC_A

4.7uF | Capacitor (Semiconductor SIMModel) | C6 | 1 FP-C0603C-CF-IPC_A

100nF | Capacitor (Semiconductor SIMModel) | C7 | 1 FP-C0603C-CF-IPC_A

100nF | Capacitor (Semiconductor SIMModel) | C8 | 1 FP-C0603C-CF-IPC_A

4.7uF | Capacitor (Semiconductor SIMModel) | C9 | 1 FP-C0603C-CF-IPC_A

1uF | Capacitor (Semiconductor SIMModel) | C10 | 1 FP-C0603C-CF-IPC_A

1uF | Capacitor (Semiconductor SIMModel) | C11 | 1 FP-C0603C-CF-IPC_A

10pF | Capacitor (Semiconductor SIMModel) | C12 | 1 FP-C0603C-CF-IPC_A

4,7pF | Capacitor (Semiconductor SIMModel) | C13 | 1 FP-C0603C-CF-IPC_A

10nF | Capacitor (Semiconductor SIMModel) | C14 | 1 FP-C0603C-CF-IPC_A

1uF | Capacitor (Semiconductor SIMModel) | C15 | 1 FP-C0603C-CF-IPC_A

10nF | Capacitor (Semiconductor SIMModel) | C16 | 1 FP-C0603C-CF-IPC_A

1uF | Capacitor (Semiconductor SIMModel) | C17 | 1 FP-C0603C-CF-IPC_A

10nF | Capacitor (Semiconductor SIMModel) | C18 | 1 FP-C0603C-CF-IPC_A

1uF | Capacitor (Semiconductor SIMModel) | C19 | 1 FP-C0603C-CF-IPC_A

10nF | Capacitor (Semiconductor SIMModel) | C20 | 1 FP-C0603C-CF-IPC_A

1uF | Capacitor (Semiconductor SIMModel) | C21 | 1 FP-C0603C-CF-IPC_A

10nF | Capacitor (Semiconductor SIMModel) | C22 | 1 FP-C0603C-CF-IPC_A

1uF | Capacitor (Semiconductor SIMModel) | C23 | 1 FP-C0603C-CF-IPC_A

10pF | Capacitor (Semiconductor SIMModel) | C24 | 1 FP-C0603C-CF-IPC_A

100nF | Capacitor (Semiconductor SIMModel) | C25 | 1 FP-C0603C-CF-IPC_A

4,7pF | Capacitor (Semiconductor SIMModel) | C26 | 1 FP-C0603C-CF-IPC_A

10nF | Capacitor (Semiconductor SIMModel) | C27 | 1 FP-C0603C-CF-IPC_A

10nF | Capacitor (Semiconductor SIMModel) | C28 | 1 FP-C0603C-CF-IPC_A

10nF | Capacitor (Semiconductor SIMModel) | C29 | 1 FP-C0603C-CF-IPC_A

10nF | Capacitor Capacitor (Semiconductor SIMModel) (Semiconductor SIMModel) Capacitor | C30 C31 | 1 FP-C0603C-CF-1 FP-C0603C-CF-IPC_A IPC_A

10nF | (Semiconductor SIMModel) Capacitor | C32 | 1 FP-C0603C-CF-IPC_A

100nF | (Semiconductor SIMModel) Capacitor | C33 | 1 FP-C0603C-CF-IPC_A

100nF | (Semiconductor SIMModel) | C34 | 1 FP-C0603C-CF-IPC_A

100nF | Capacitor (Semiconductor SIMModel) | C35 | 1 FP-C0603C-CF-IPC_A

100nF | Capacitor (Semiconductor SIMModel) | C36 | 1 FP-C0603C-CF-IPC_A

PESD5V0L2BT,215 BZX84C3V6LT1G BZX84C3V6LT1G BZX84C3V6LT1G BZX84C3V6LT1G BZX84C3V6LT1G BZX84C3V6LT1G BZX84C3V6LT1G BZX84C3V6LT1G BZX84C3V6LT1G BZX84C3V6LT1G BZX84C3V6LT1G BZX84C3V6LT1G BZX84C3V6LT1G BZX84C3V6LT1G BZX84C3V6LT1G BZX84C3V6LT1G BZX84C3V6LT1G BZX84C3V6LT1G BZX84C3V6LT1G BZX84C3V6LT1G BZX84C3V6LT1G BZX84C3V6LT1G SK56A-LTP LED_USB_RX_TX | 430mcd Colorless transparence 520nm Emerald 140°LED0603Light EmittingDiodes (LED) ROHS | D1 D2 D4 D3 D5 D7 D6 D8 D10 D9 D11 D13 D12 D14 D16 D15 D17 D19 D18 D20 D22 D21 D23 D24 D25 | 1 SOT95P230X110-1 SOT95P240X111-3N 3N 1 SOT95P240X111-1 SOT95P240X111-3N 1 SOT95P240X111-3N 3N 1 SOT95P240X111-1 SOT95P240X111-3N 1 SOT95P240X111-3N 3N 1 SOT95P240X111-1 SOT95P240X111-3N 1 SOT95P240X111-3N 3N 1 SOT95P240X111-1 SOT95P240X111-3N 1 SOT95P240X111-3N 3N 1 SOT95P240X111-1 SOT95P240X111-3N 1 SOT95P240X111-3N 3N 1 SOT95P240X111-1 SOT95P240X111-3N 1 SOT95P240X111-3N 3N 1 SOT95P240X111-1 SOT95P240X111-3N 1 SOT95P240X111-3N 3N 1 DIOM5225X244N 1 WL-SMCW_0603_1500 60xx75000

LED_CAN_RX_TX | 430mcd Colorless transparence 520nm Emerald 140°LED0603Light EmittingDiodes (LED) ROHS | D26 | 1 WL-SMCW_0603_1500 60xx75000

LED_ERROR | 430mcd Colorless transparence 520nm Emerald 140°LED0603Light EmittingDiodes (LED) ROHS | D27 | WL-1 SMCW_0603_1500 60xx75000

0ZCH0150FF2E 0ZCH0150FF2E 0ZCH0150FF2E 0ZCH0150FF2E | 1210SMTPPTC| 1.50Ih | 6V 1210SMTPPTC| 1.50Ih | 6V 1210SMTPPTC| 1.50Ih | 6V 1210SMTPPTC| 1.50Ih | 6V 1210SMTPPTC| 1.50Ih | 6V 1210SMTPPTC| 1.50Ih | 6V 1210SMTPPTC| 1.50Ih | 6V 1210SMTPPTC| 1.50Ih | 6V | F1 F2 F4 F3 F5 F7 F6 F8 | 1 FUSC3225X90N 1 FUSC3225X90N 1 FUSC3225X90N 1 FUSC3225X90N

0ZCH0150FF2E 0ZCH0150FF2E 0ZCH0150FF2E 0ZCH0150FF2E 0ZCH0150FF2E 0ZCH0150FF2E 0ZCH0150FF2E 0ZCH0150FF2E 0ZCH0150FF2E 0ZCH0150FF2E 0ZCH0150FF2E 0ZCH0150FF2E 0ZCH0150FF2E 0ZCH0150FF2E 0ZCH0150FF2E 0ZCH0150FF2E 0ZCH0150FF2E 0ZCH0150FF2E 0ZCH0150FF2E 0ZCH0150FF2E 0ZCH0150FF2E 0ZCH0150FF2E MountingHole_Pad | 1210SMTPPTC| 1.50Ih | 6V 1210SMTPPTC| 1.50Ih | 6V 1210SMTPPTC| 1.50Ih | 6V 1210SMTPPTC| 1.50Ih | 6V 1210SMTPPTC| 1.50Ih | 6V 1210SMTPPTC| 1.50Ih | 6V 1210SMTPPTC| 1.50Ih | 6V 1210SMTPPTC| 1.50Ih | 6V 1210SMTPPTC| 1.50Ih | 6V 1210SMTPPTC| 1.50Ih | 6V 1210SMTPPTC| 1.50Ih | 6V 1210SMTPPTC| 1.50Ih | 6V 1210SMTPPTC| 1.50Ih | 6V 1210SMTPPTC| 1.50Ih | 6V 1210SMTPPTC| 1.50Ih | 6V 1210SMTPPTC| 1.50Ih | 6V 1210SMTPPTC| 1.50Ih | 6V 1210SMTPPTC| 1.50Ih | 6V 1210SMTPPTC| 1.50Ih | 6V 1210SMTPPTC| 1.50Ih | 6V 1210SMTPPTC| 1.50Ih | 6V 1210SMTPPTC| 1.50Ih | 6V | F10 F9 F11 F13 F12 F14 F16 F15 F17 F19 F18 F20 F22 F21 F23 F25 F24 F26 F28 F27 F29 F30 H1 | 1 FUSC3225X90N 1 FUSC3225X90N 1 FUSC3225X90N 1 FUSC3225X90N 1 FUSC3225X90N 1 FUSC3225X90N 1 FUSC3225X90N 1 FUSC3225X90N 1 FUSC3225X90N 1 FUSC3225X90N 1 FUSC3225X90N 1 FUSC3225X90N 1 FUSC3225X90N 1 FUSC3225X90N 1 FUSC3225X90N 1 FUSC3225X90N 1 FUSC3225X90N 1 FUSC3225X90N 1 FUSC3225X90N 1 FUSC3225X90N 1 FUSC3225X90N 1 FUSC3225X90N MountingHole_2.7 1 mm_M2.5_DIN965 _Pad

MountingHole_Pad | H2 | MountingHole_2.7 1 mm_M2.5_DIN965 _Pad

MountingHole_Pad | H3 | MountingHole_2.7 1 mm_M2.5_DIN965 _Pad

MountingHole_Pad | H4 | MountingHole_2.7 1 mm_M2.5_DIN965 _Pad

JP8 Screw_terminal 1x6 Screw_terminal 1x6 Screw_terminal 1x6 Screw_terminal 1x6 Screw_terminal 1x4 Screw_terminal 1x6 Screw_terminal 1x6 Screw_terminal 1x6 Screw_terminal 1x6 Screw_terminal 1x4 Screw_terminal 1x2 BUK9M15-60EX | Connector 8 Header, 6-Pin Header, 6-Pin Header, 6-Pin Header, 4-Pin Header, 5-Pin Header, 6-Pin Header, 6-Pin Header, 6-Pin Header, 6-Pin Header, 4-Pin Header, 2-Pin Bá»™chuyá»ƒn Ä‘á»•i N-Channel 60V47A(Tc) 75W (Tc) gáº¯n bá» máº·t LFPAK33 | JP1 P3 P2 P1 P5 P4 P8 P7 P6 P11 P10 P9 Q1 | 1 HDR/Header/8 1 HDR/Terminal/6 1 HDR/Terminal/6 1 HDR/Terminal/6 1 HDR/Terminal/4 1 HDR/Terminal/5/R A 1 HDR/Terminal/6 1 HDR/Terminal/6 1 HDR/Terminal/6 1 HDR/Terminal/6 1 HDR/Terminal/4 1 HDR/Terminal/2 1 TRANS_BUK9M15-60EX

BUK9M15-60EX | Bá»™chuyá»ƒn Ä‘á»•i N-Channel 60V47A(Tc) 75W (Tc) gáº¯n bá» máº·t LFPAK33 | Q2 | 1 TRANS_BUK9M15-60EX

BUK9M15-60EX | Bá»™chuyá»ƒn Ä‘á»•i N-Channel 60V47A(Tc) 75W (Tc) gáº¯n bá» máº·t LFPAK33 | Q3 | 1 TRANS_BUK9M15-60EX

BUK9M15-60EX | Bá»™chuyá»ƒn Ä‘á»•i N-Channel 60V47A(Tc) 75W (Tc) gáº¯n bá» máº·t LFPAK33 | Q4 | 1 TRANS_BUK9M15-60EX

BUK9M15-60EX | Bá»™chuyá»ƒn Ä‘á»•i N-Channel 60V47A(Tc) 75W (Tc) gáº¯n bá» máº·t LFPAK33 | Q5 | 1 TRANS_BUK9M15-60EX

BUK9M15-60EX | Bá»™chuyá»ƒn Ä‘á»•i N-Channel 60V47A(Tc) 75W (Tc) gáº¯n bá» máº·t LFPAK33 | Q6 | 1 TRANS_BUK9M15-60EX

BUK9M15-60EX | Bá»™chuyá»ƒn Ä‘á»•i N-Channel 60V47A(Tc) 75W (Tc) gáº¯n bá» máº·t LFPAK33 | Q7 | 1 TRANS_BUK9M15-60EX

BUK9M15-60EX | Bá»™chuyá»ƒn Ä‘á»•i N-Channel 60V47A(Tc) 75W (Tc) gáº¯n bá» máº·t LFPAK33 | Q8 | 1 TRANS_BUK9M15-60EX

ST-LinkV2connector SW MIC5504-3.3YM5_TR | Header, 6-Pin Linear Voltage Switch button 2 pin Regulator IC PositiveFixed 1 Output 300mA SOT-23-5 | STLINK2 SW1 U1 | 1 HDR/Header/6 1 SW1-SMD 1 SOT95P280X145-5N

STM32F373VBTx TCAN332D PC817X3NSZ1B | Optoisolator 3.3-VCAN Transceivers Transistor Output -1Channel 4-DIP | U2 U3 U4 | 1 QFP50P1600X1600 X160-100N 1 SOIC127P599X175-8N 1 DIP762W50P254L4 95H455Q4

PC817X3NSZ1B | Optoisolator Transistor Output -1Channel 4-DIP | U5 | 1 DIP762W50P254L4 95H455Q4

PC817X3NSZ1B | Optoisolator Transistor Output -1Channel 4-DIP | U6 | 1 DIP762W50P254L4 95H455Q4

PC817X3NSZ1B | Optoisolator Transistor Output -1Channel 4-DIP | U7 | 1 DIP762W50P254L4 95H455Q4

PC817X3NSZ1B | Optoisolator Transistor Output -1Channel 4-DIP | U8 | 1 DIP762W50P254L4 95H455Q4

PC817X3NSZ1B | Optoisolator Transistor Output -1Channel 4-DIP | U9 | 1 DIP762W50P254L4 95H455Q4

PC817X3NSZ1B | Optoisolator Transistor Output -1Channel 4-DIP | U10 | 1 DIP762W50P254L4 95H455Q4

PC817X3NSZ1B | Optoisolator Transistor Output -1Channel 4-DIP | U11 | 1 DIP762W50P254L4 95H455Q4

PC817X3NSZ1B | Optoisolator Transistor Output -1Channel 4-DIP | U12 | 1 DIP762W50P254L4 95H455Q4

PC817X3NSZ1B | Optoisolator Transistor Output -1Channel 4-DIP | U13 | 1 DIP762W50P254L4 95H455Q4

PC817X3NSZ1B | Optoisolator Transistor Output -1Channel 4-DIP | U14 | 1 DIP762W50P254L4 95H455Q4

PC817X3NSZ1B | Optoisolator Transistor Output -1Channel 4-DIP | U15 | 1 DIP762W50P254L4 95H455Q4

PC817X3NSZ1B | Optoisolator Transistor Output -1Channel 4-DIP | U16 | 1 DIP762W50P254L4 95H455Q4

PC817X3NSZ1B | Optoisolator Transistor Output -1Channel 4-DIP | U17 | 1 DIP762W50P254L4 95H455Q4

PC817X3NSZ1B | Optoisolator Transistor Output -1Channel 4-DIP | U18 | 1 DIP762W50P254L4 95H455Q4

PC817X3NSZ1B | Optoisolator Transistor Output -1Channel 4-DIP | U19 | 1 DIP762W50P254L4 95H455Q4

PC817X3NSZ1B | Optoisolator Transistor Output -1Channel 4-DIP | U20 | 1 DIP762W50P254L4 95H455Q4

PC817X3NSZ1B | Optoisolator Transistor Output -1Channel 4-DIP | U21 | 1 DIP762W50P254L4 95H455Q4

PC817X3NSZ1B | Optoisolator Transistor Output -1Channel 4-DIP | U22 | 1 DIP762W50P254L4 95H455Q4

PC817X3NSZ1B | Optoisolator Transistor Output -1Channel 4-DIP | U23 | 1 DIP762W50P254L4 95H455Q4

LM2902 | Low power general-purpose quad operational amplifier 14-SOIC 0to 70 | U24 | 1 SOIC127P600X175-14N

LM2904DR SN74HC14N | Dual, 26-V, 700-HexSchmitt-kHzoperational amplifier Trigger Inverters, N0014A, TUBE HexSchmitt- | U25 U30 | 1 SOIC127P599X175-1 N0014A 8N | Texas Instruments

SN74HC14N | Trigger Inverters, N0014A, TUBE USB-B(USBTYPE- | U31 | 1 N0014A | Texas Instruments

USB-B1HSB6 | B) - Receptacle Connector 4 Position Through Hole, Right Angle | X1 | 1 OST_USB-B1HSB6

HSE LSE | Crystal For all Crystal 2pin. 32.768kHz Â±20ppm Crystal 7pF70kOhms 2-SMD, No Lead | X2 Y1 | 1 XT3 1 XTAL_ECS-.327-7-34B-TR
