huynguyen2311179-ui/STM32-PLC/02_Schematic_pdf/STM32-PLC.pdf

D | D
B | B
C | C
A | A
Sub-system: DA1_prj.PrjPcb | Project: STM32-PLC
Design by: Nguyễn Gia Huy | Sheet title: COVER PAGE | Sheet 1 of 11
ThS. BùiQuốcBảo Checked by: | DocNo: | Size: A3
Approved by: * | Revision: 1.0.0 | Dates: March 14

# PROJECT: STM32-PLC

# Sub-system: DA1_prj.PrjPcb

# Version: 1.0.0

D | D
B | B
C | C
A | A
Sub-system: DA1_prj.PrjPcb | Project: STM32 DEMO PCB
Design by: Nguyễn Gia Huy | Sheet title: INDEX | Sheet 2 of 11

V1.0

# INDEX

# Page Title

# 1 COVER PAGE

2
3

# INDEX

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
13 |
14 |
15 |
16 |
17 |
18 |
19 |
20 |
21 |
22 |
23 |
24 |
25 |
26 |
27 |
28 |
29 |
30 |
| | | | Page Title | | | | Page Title | | .........

# STM32_PLC INPUT DIGITAL DSDAC PULSE CAN SDADC DAC

# LED

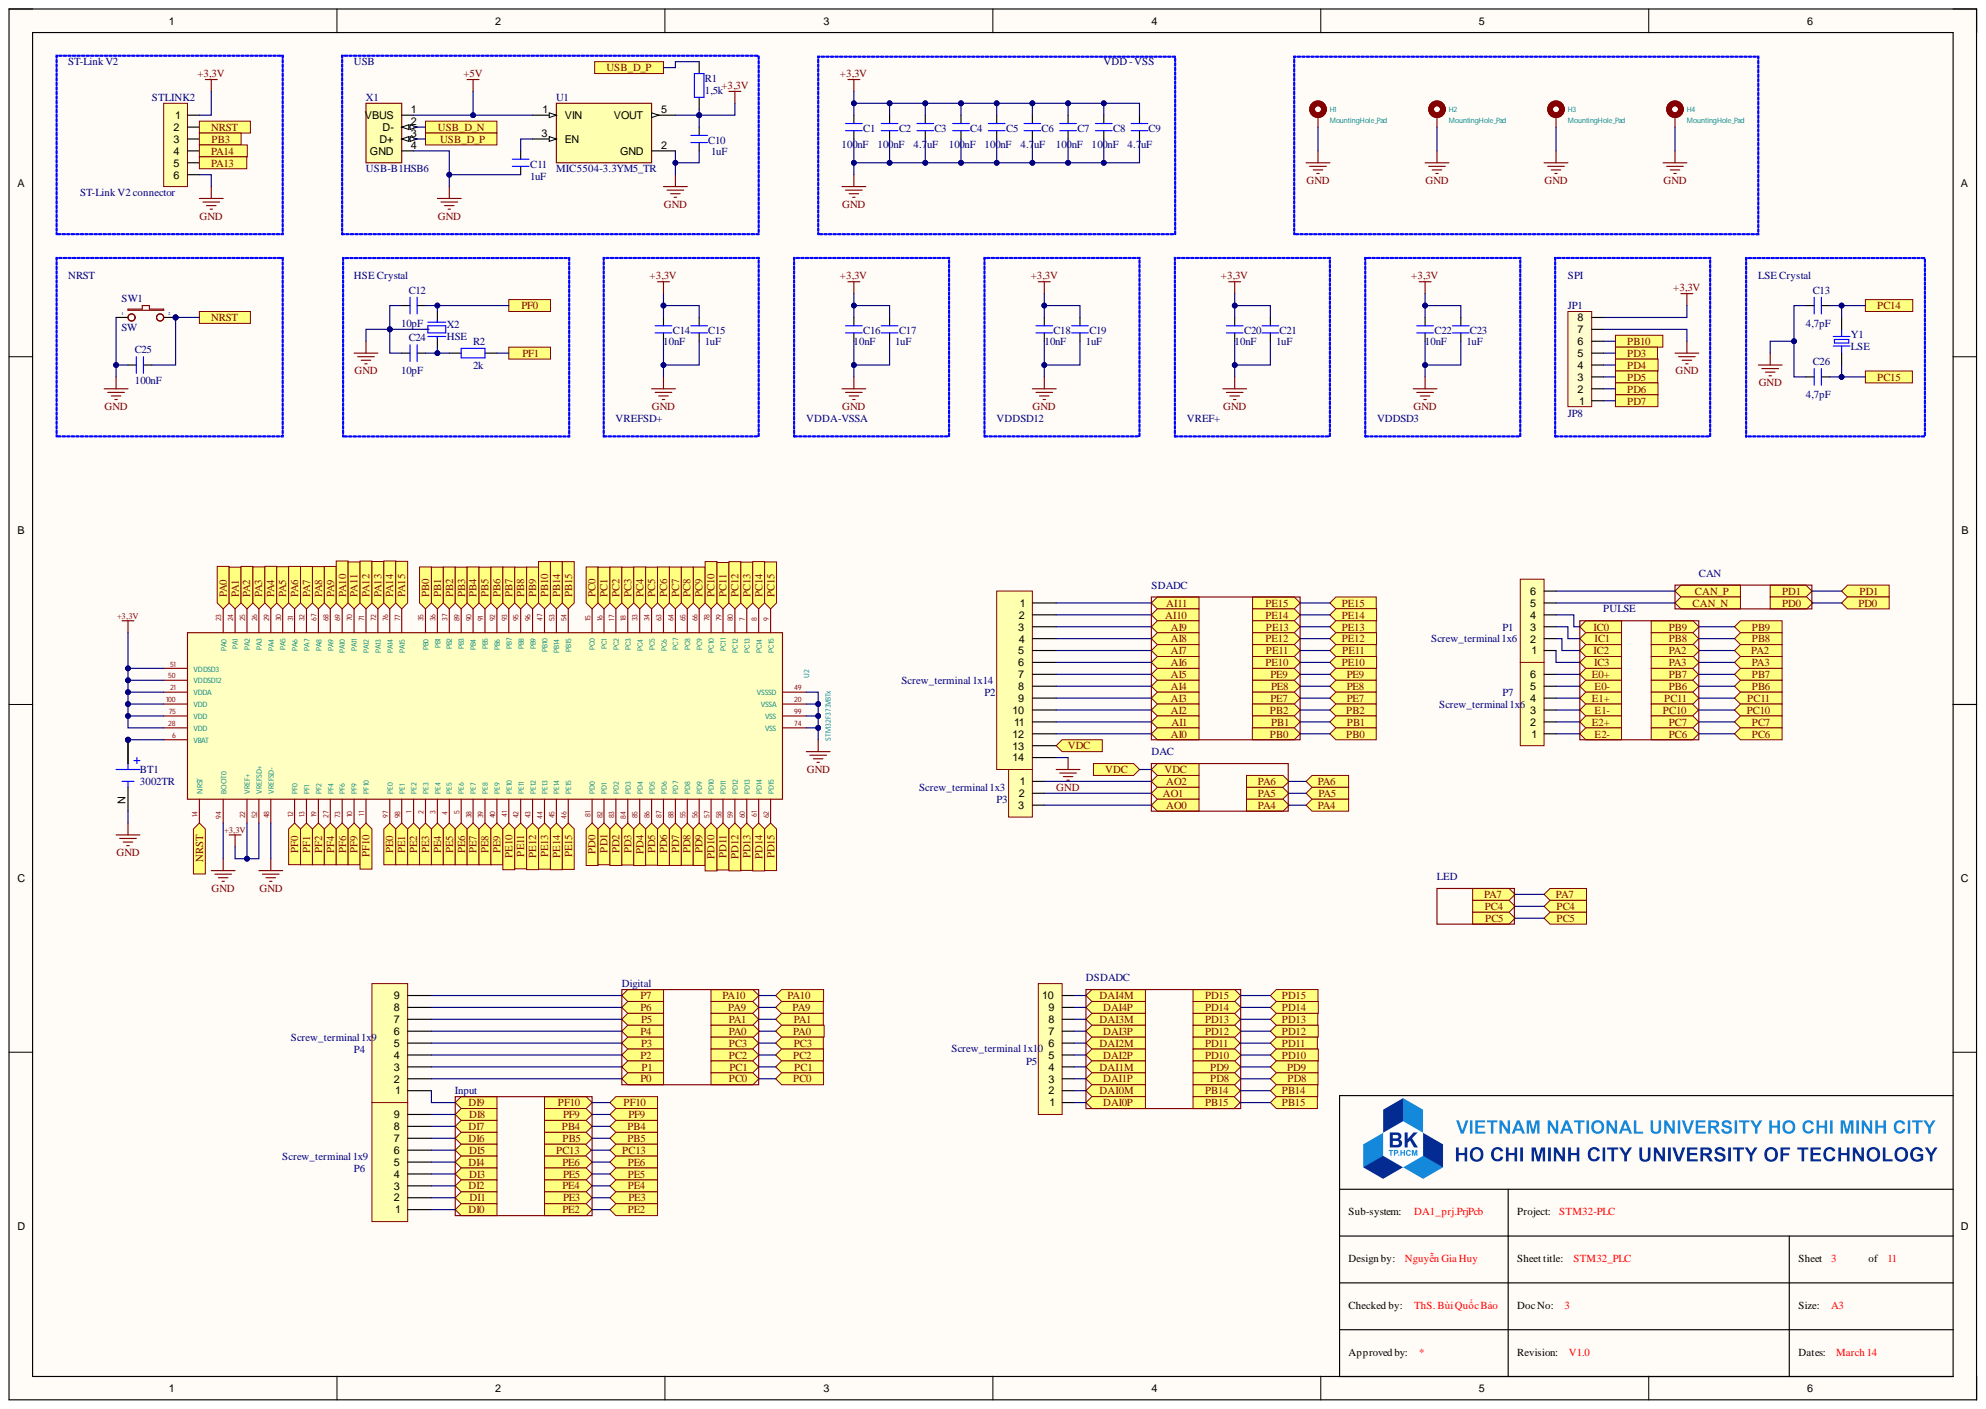
[picture p49: page 3]

Sub-system: DA1_prj.PrjPcb | Project: STM32-PLC

Design by: Nguyễn Gia Huy | Sheet title: STM32_PLC | Sheet 3 of 11

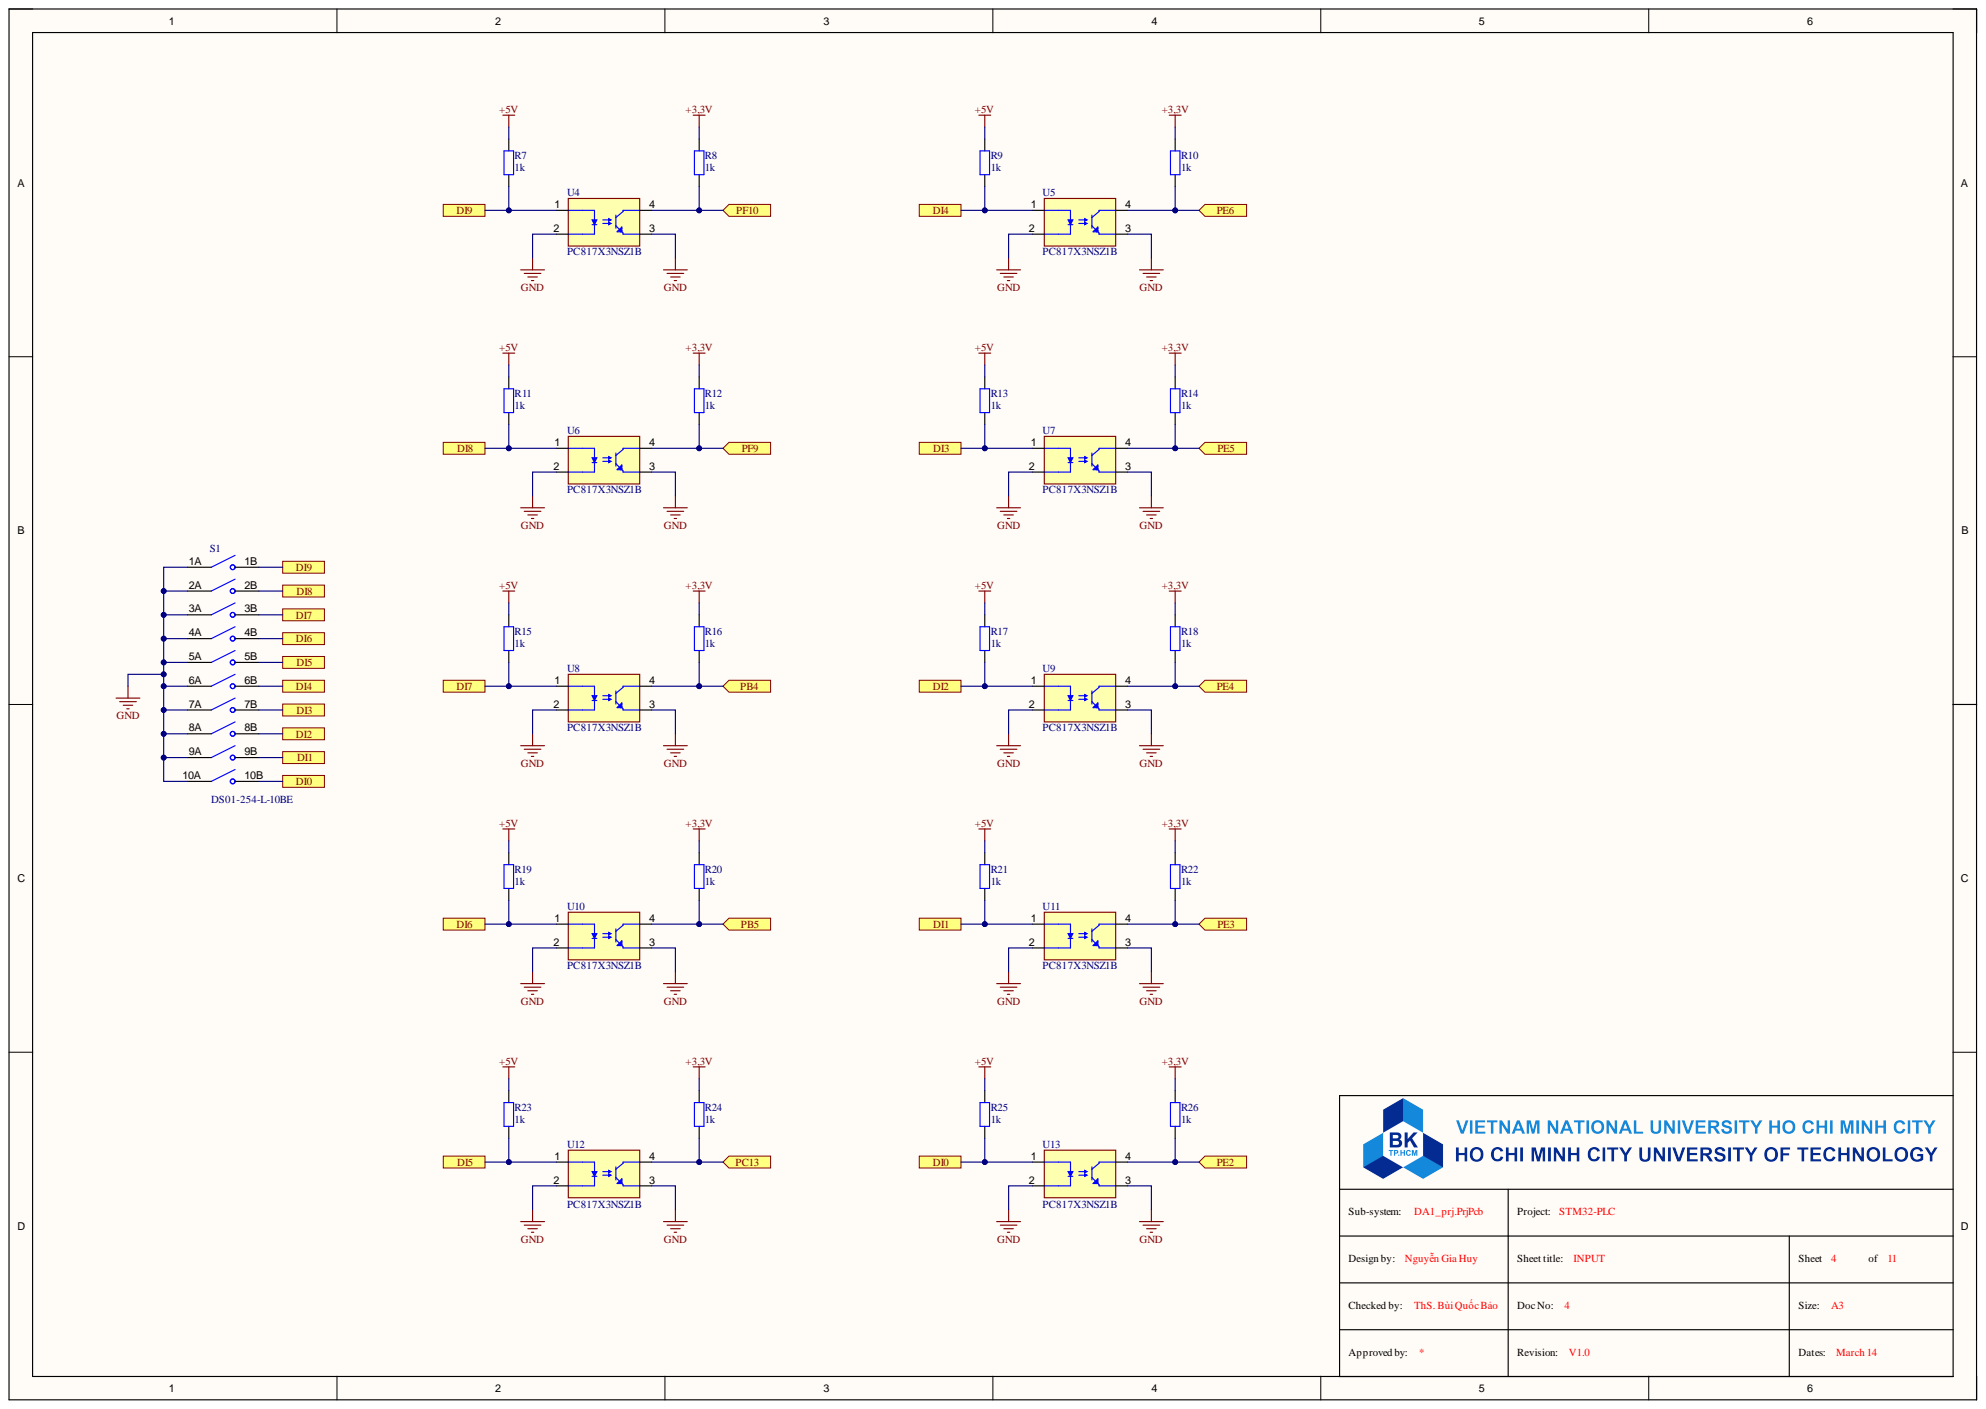
[picture p50: page 4]

Sub-system: DA1_prj.PrjPcb | Project: STM32-PLC

Design by: Nguyễn Gia Huy | Sheet title: INPUT | Sheet 4 of 11

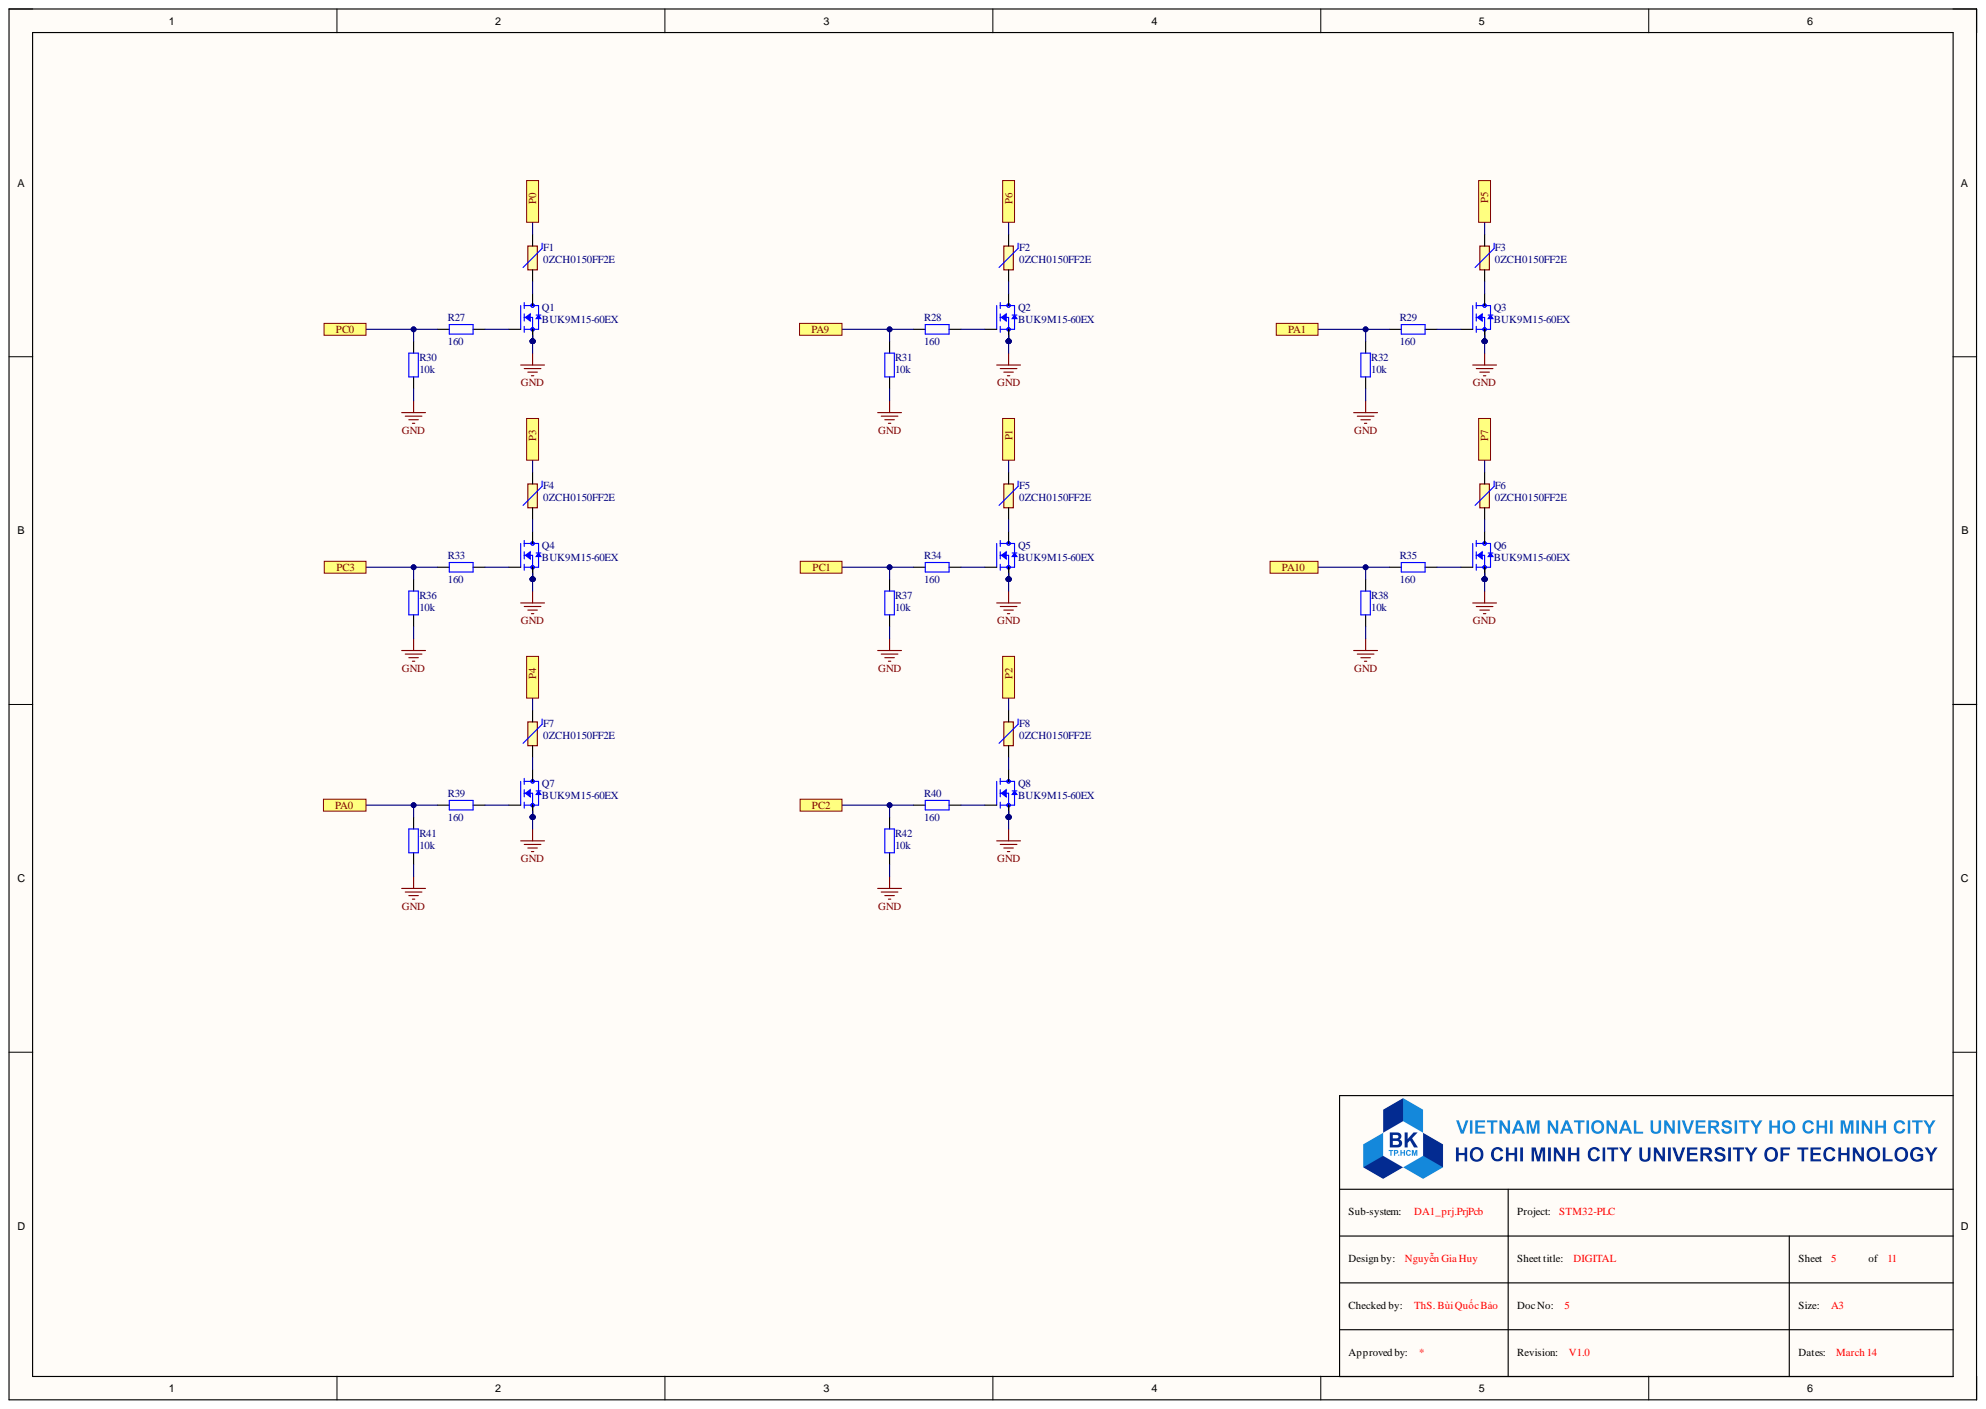
[picture p51: page 5]

S u b -s y s t em : D A 1 _ p rj . Prj P cb | P r oj e c t : S TM3 2 -PLC

Here we convert 4-20mA to 0.64-3.2V due to the 160 ohm resistor.

## Protection is avaiable due to the polyfuse and the 160 ohm resistor for

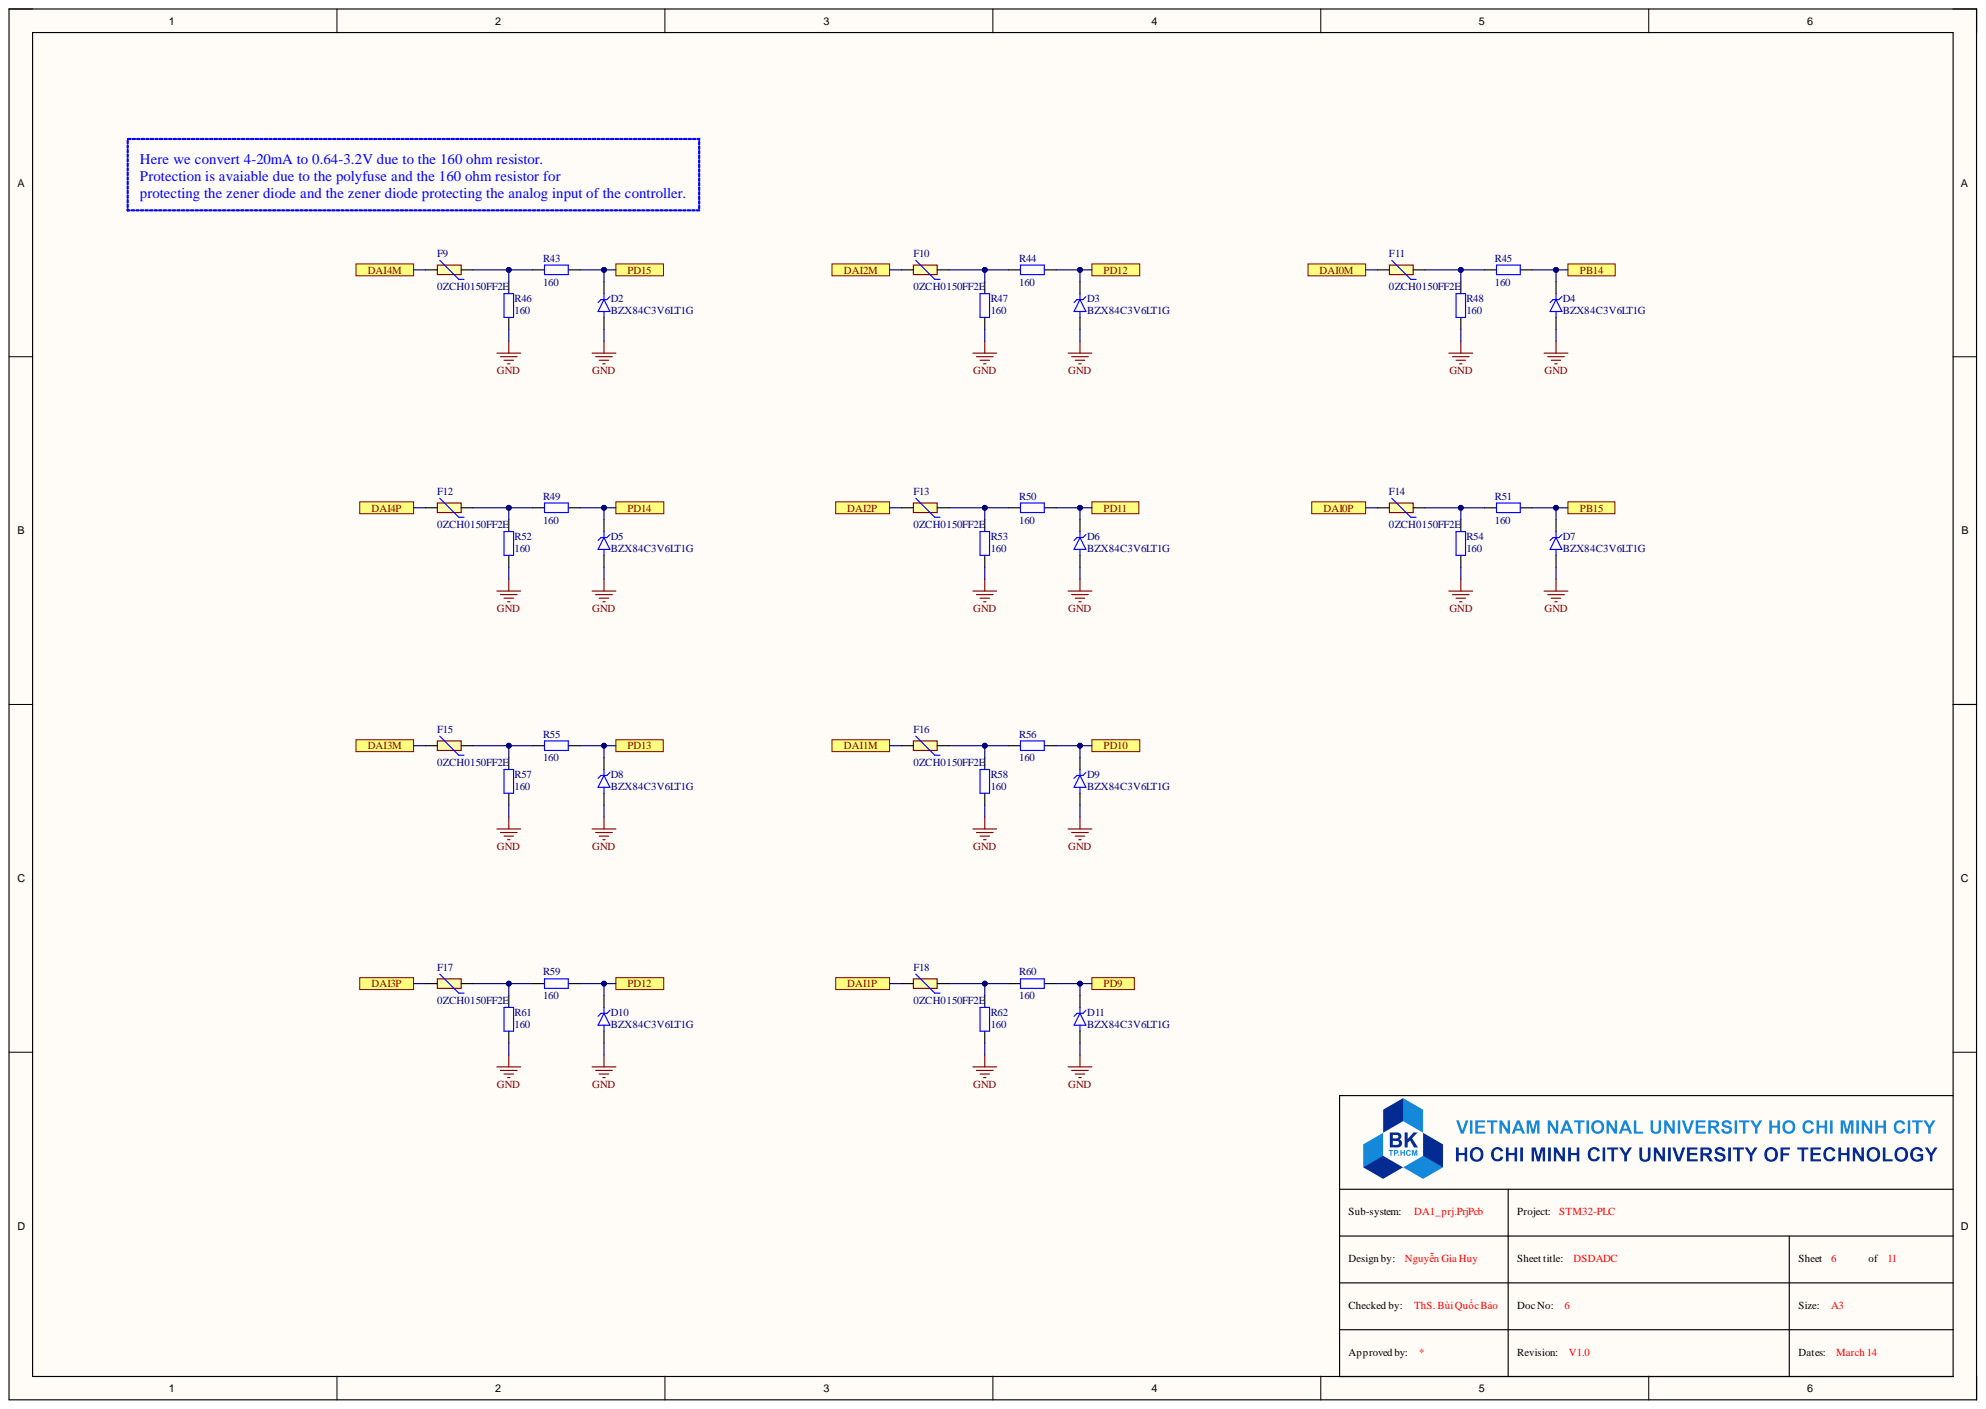
[picture p52: page 6]

protecting the zener diode and the zener diode protecting the analog input of the controller.

Sub-system: DA1_prj.PrjPcb | Project: STM32-PLC

Design by: Nguyễn Gia Huy | Sheet title: DSDADC | Sheet 6 of 11

## INPUT CAPTURE

## ENCODER

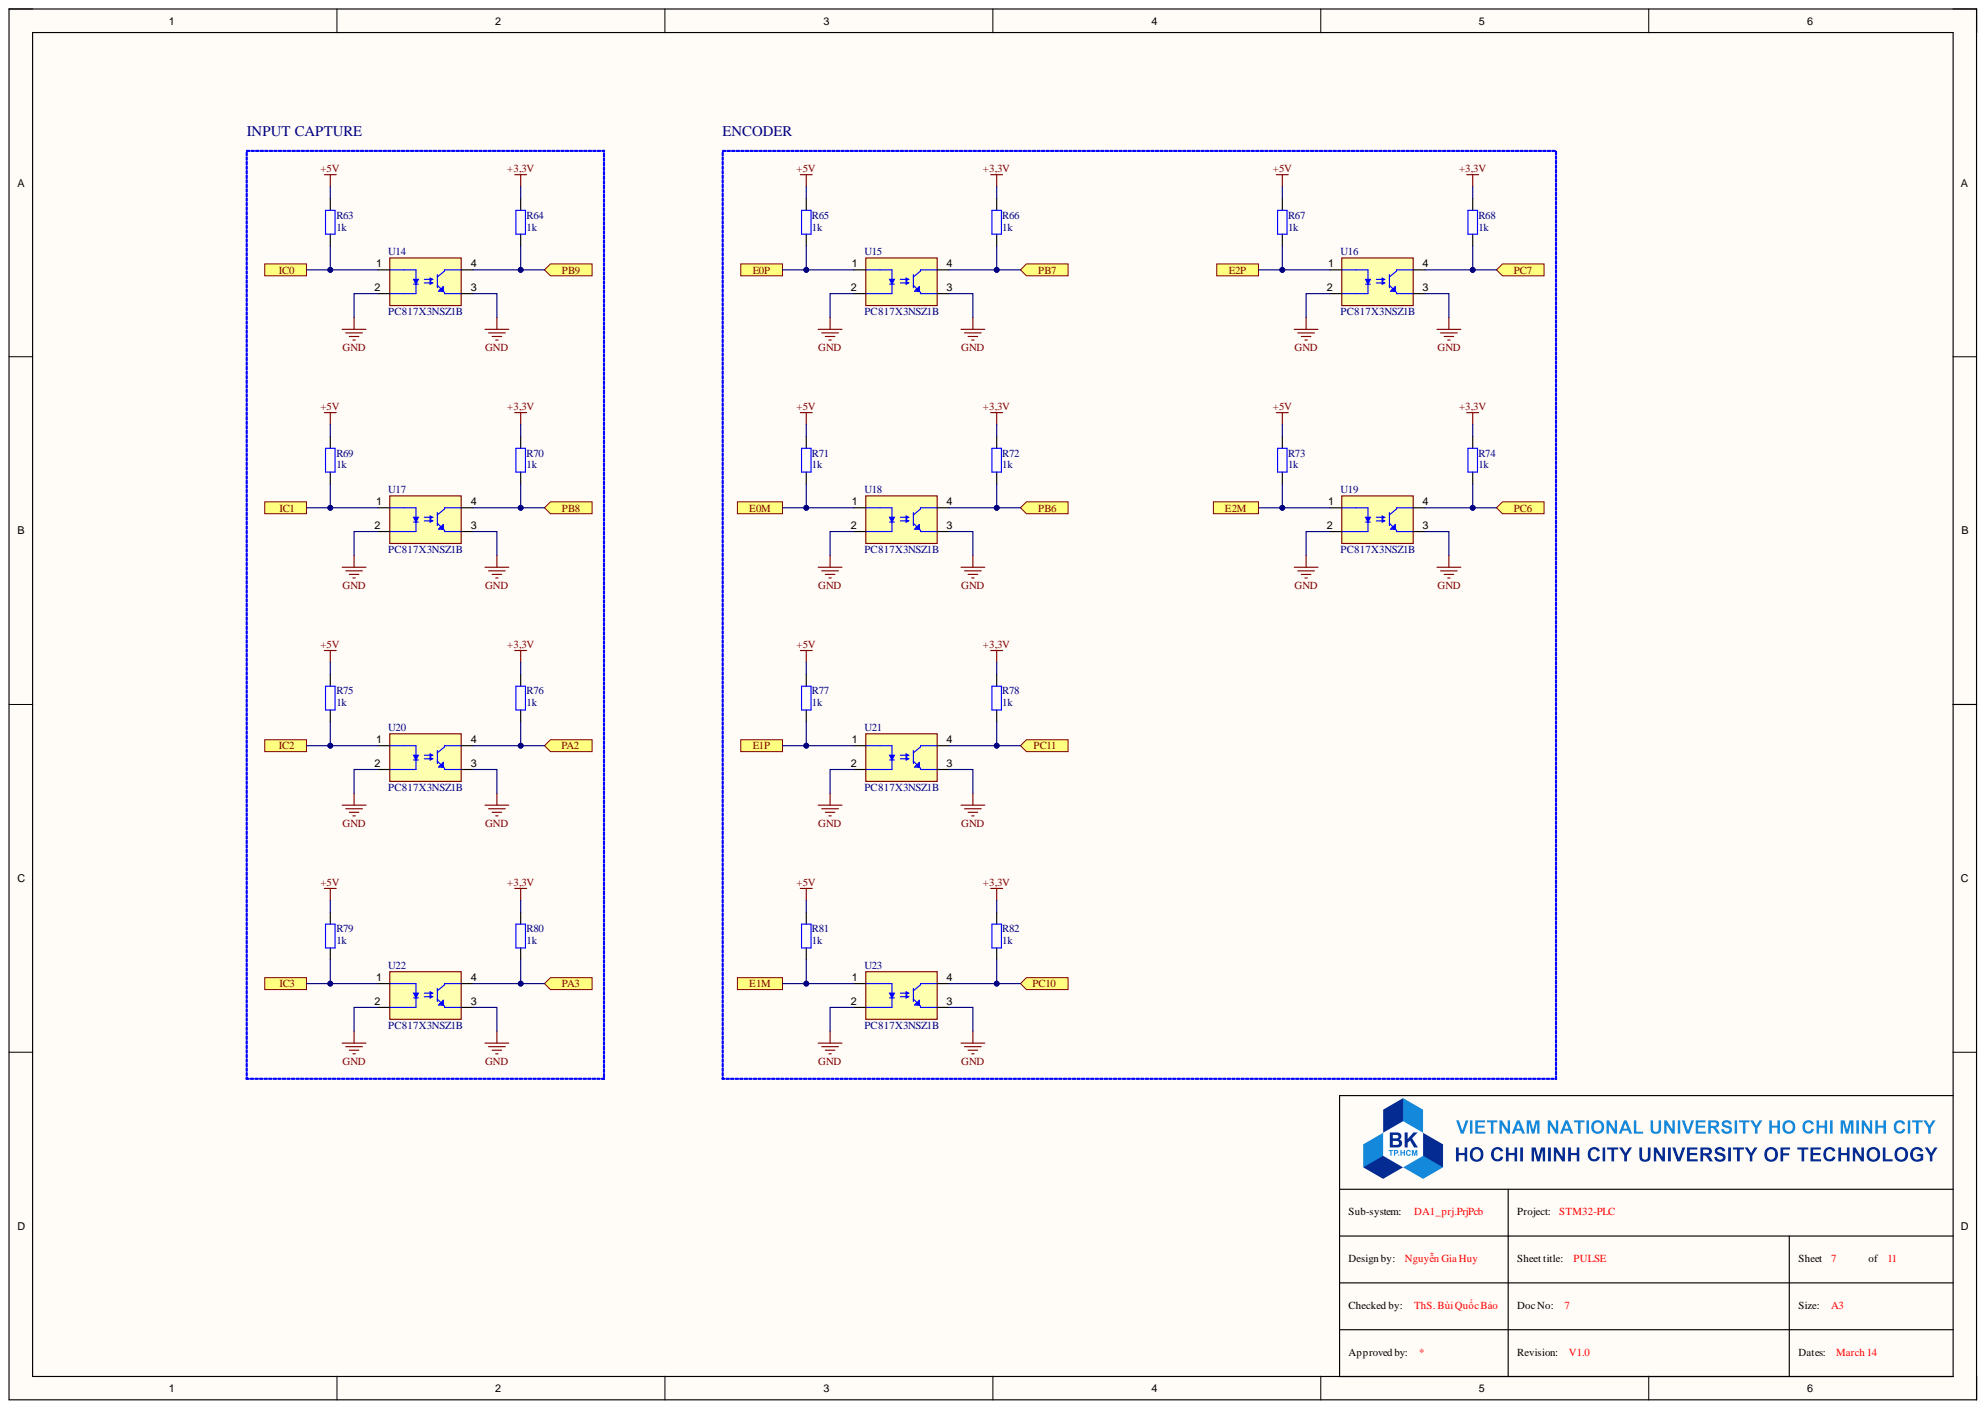
[picture p53: page 7]

Sub-system: DA1_prj.PrjPcb | Project: STM32-PLC

Design by: Nguyễn Gia Huy | Sheet title: PULSE | Sheet 7 of 11

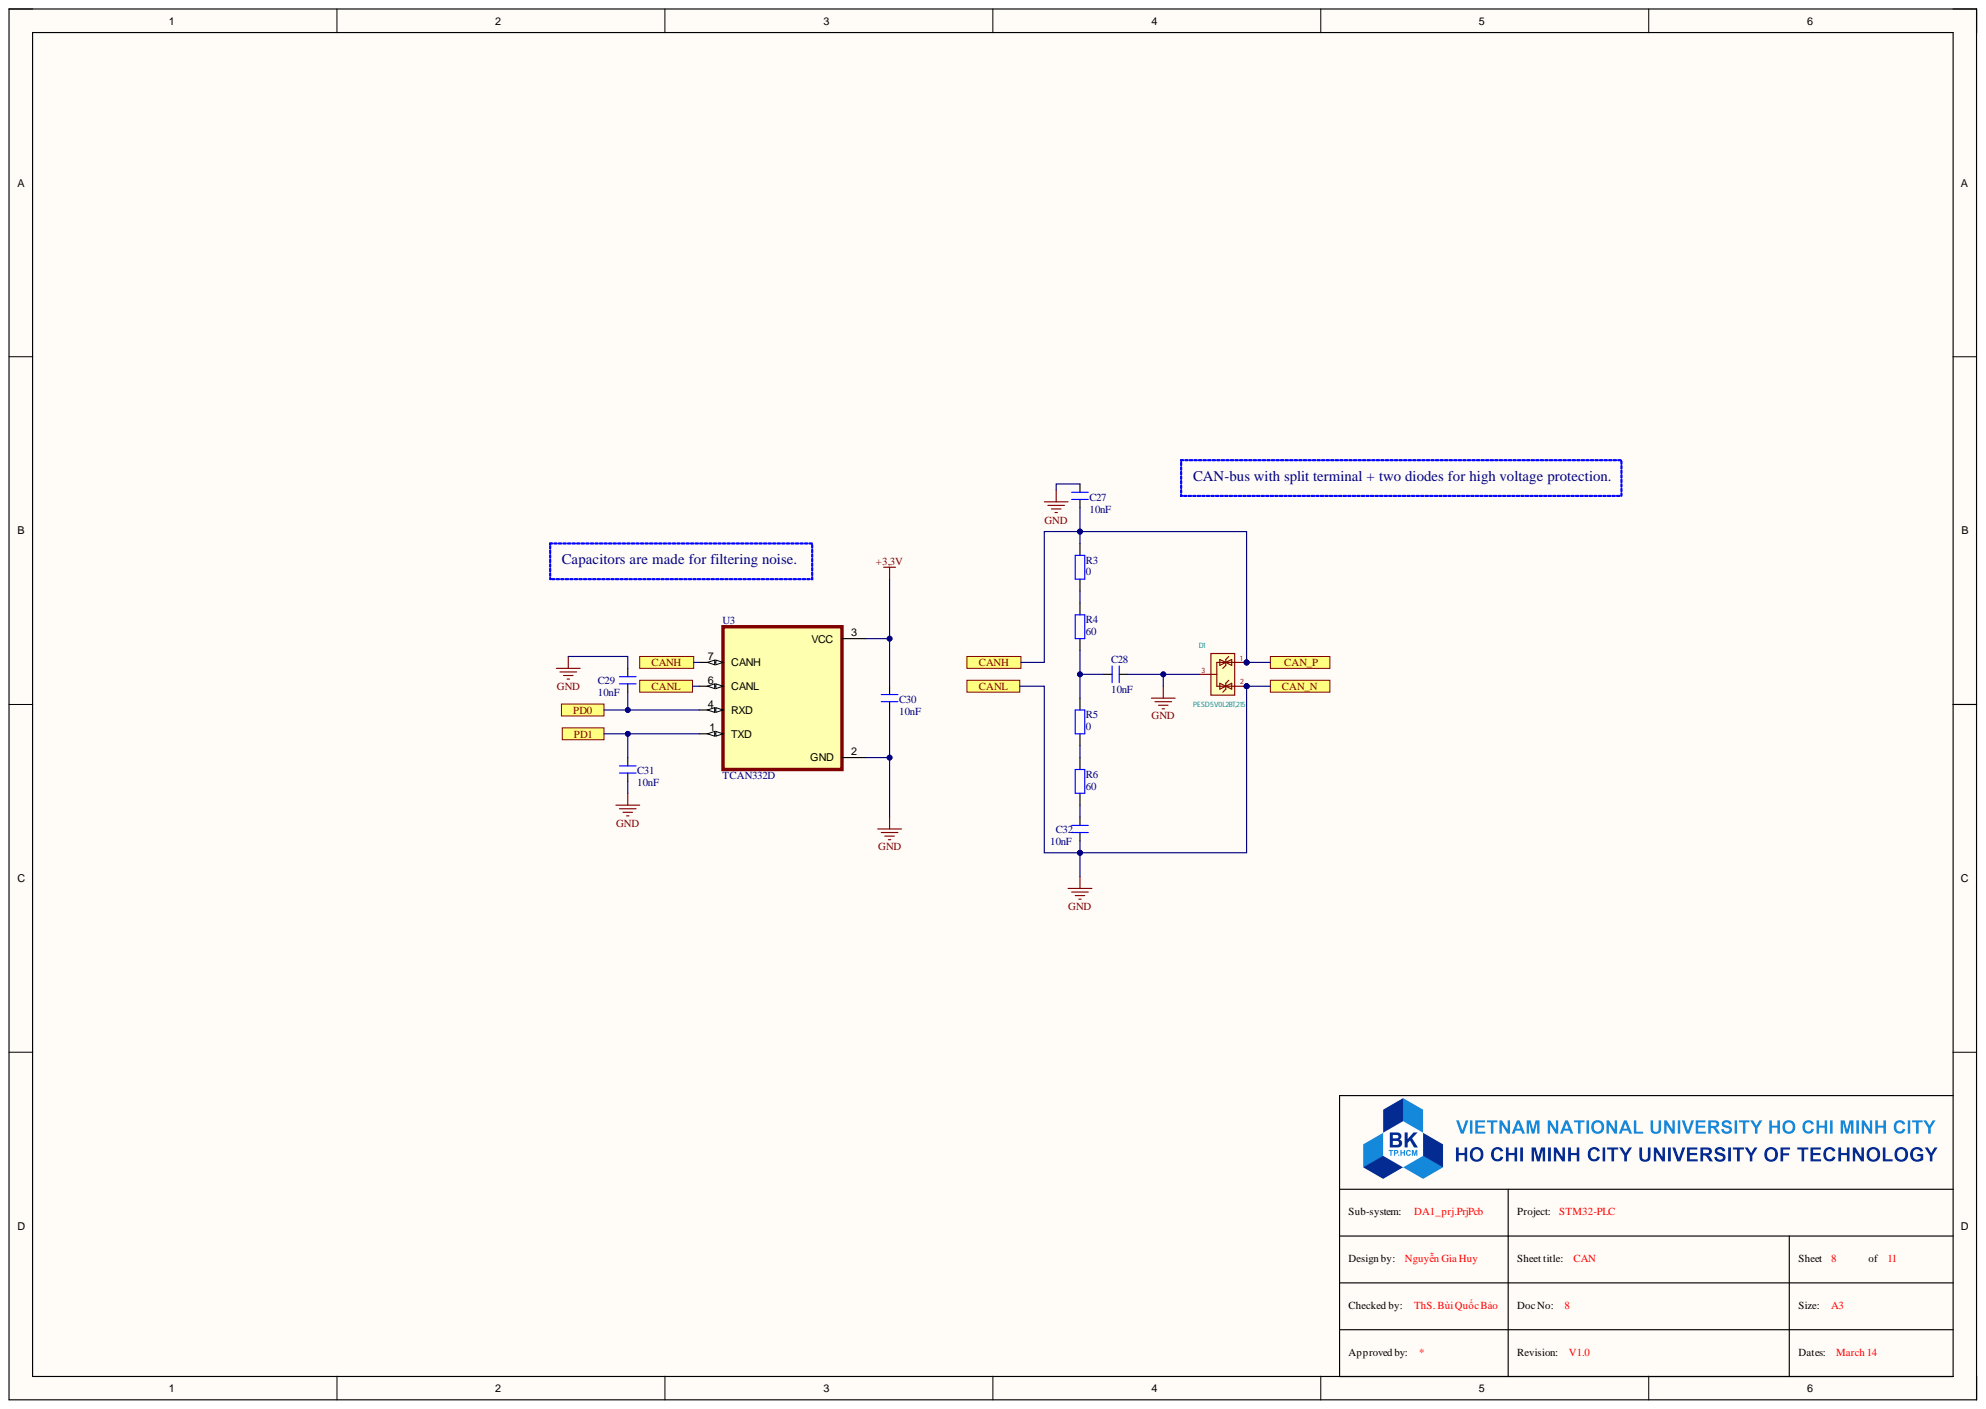
[picture p54: page 8]
ANH; apa; citors; e made; for; filte; ring noise; rminal; + two diodes; ction.

CAN-bus with split te

for high voltage prote

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

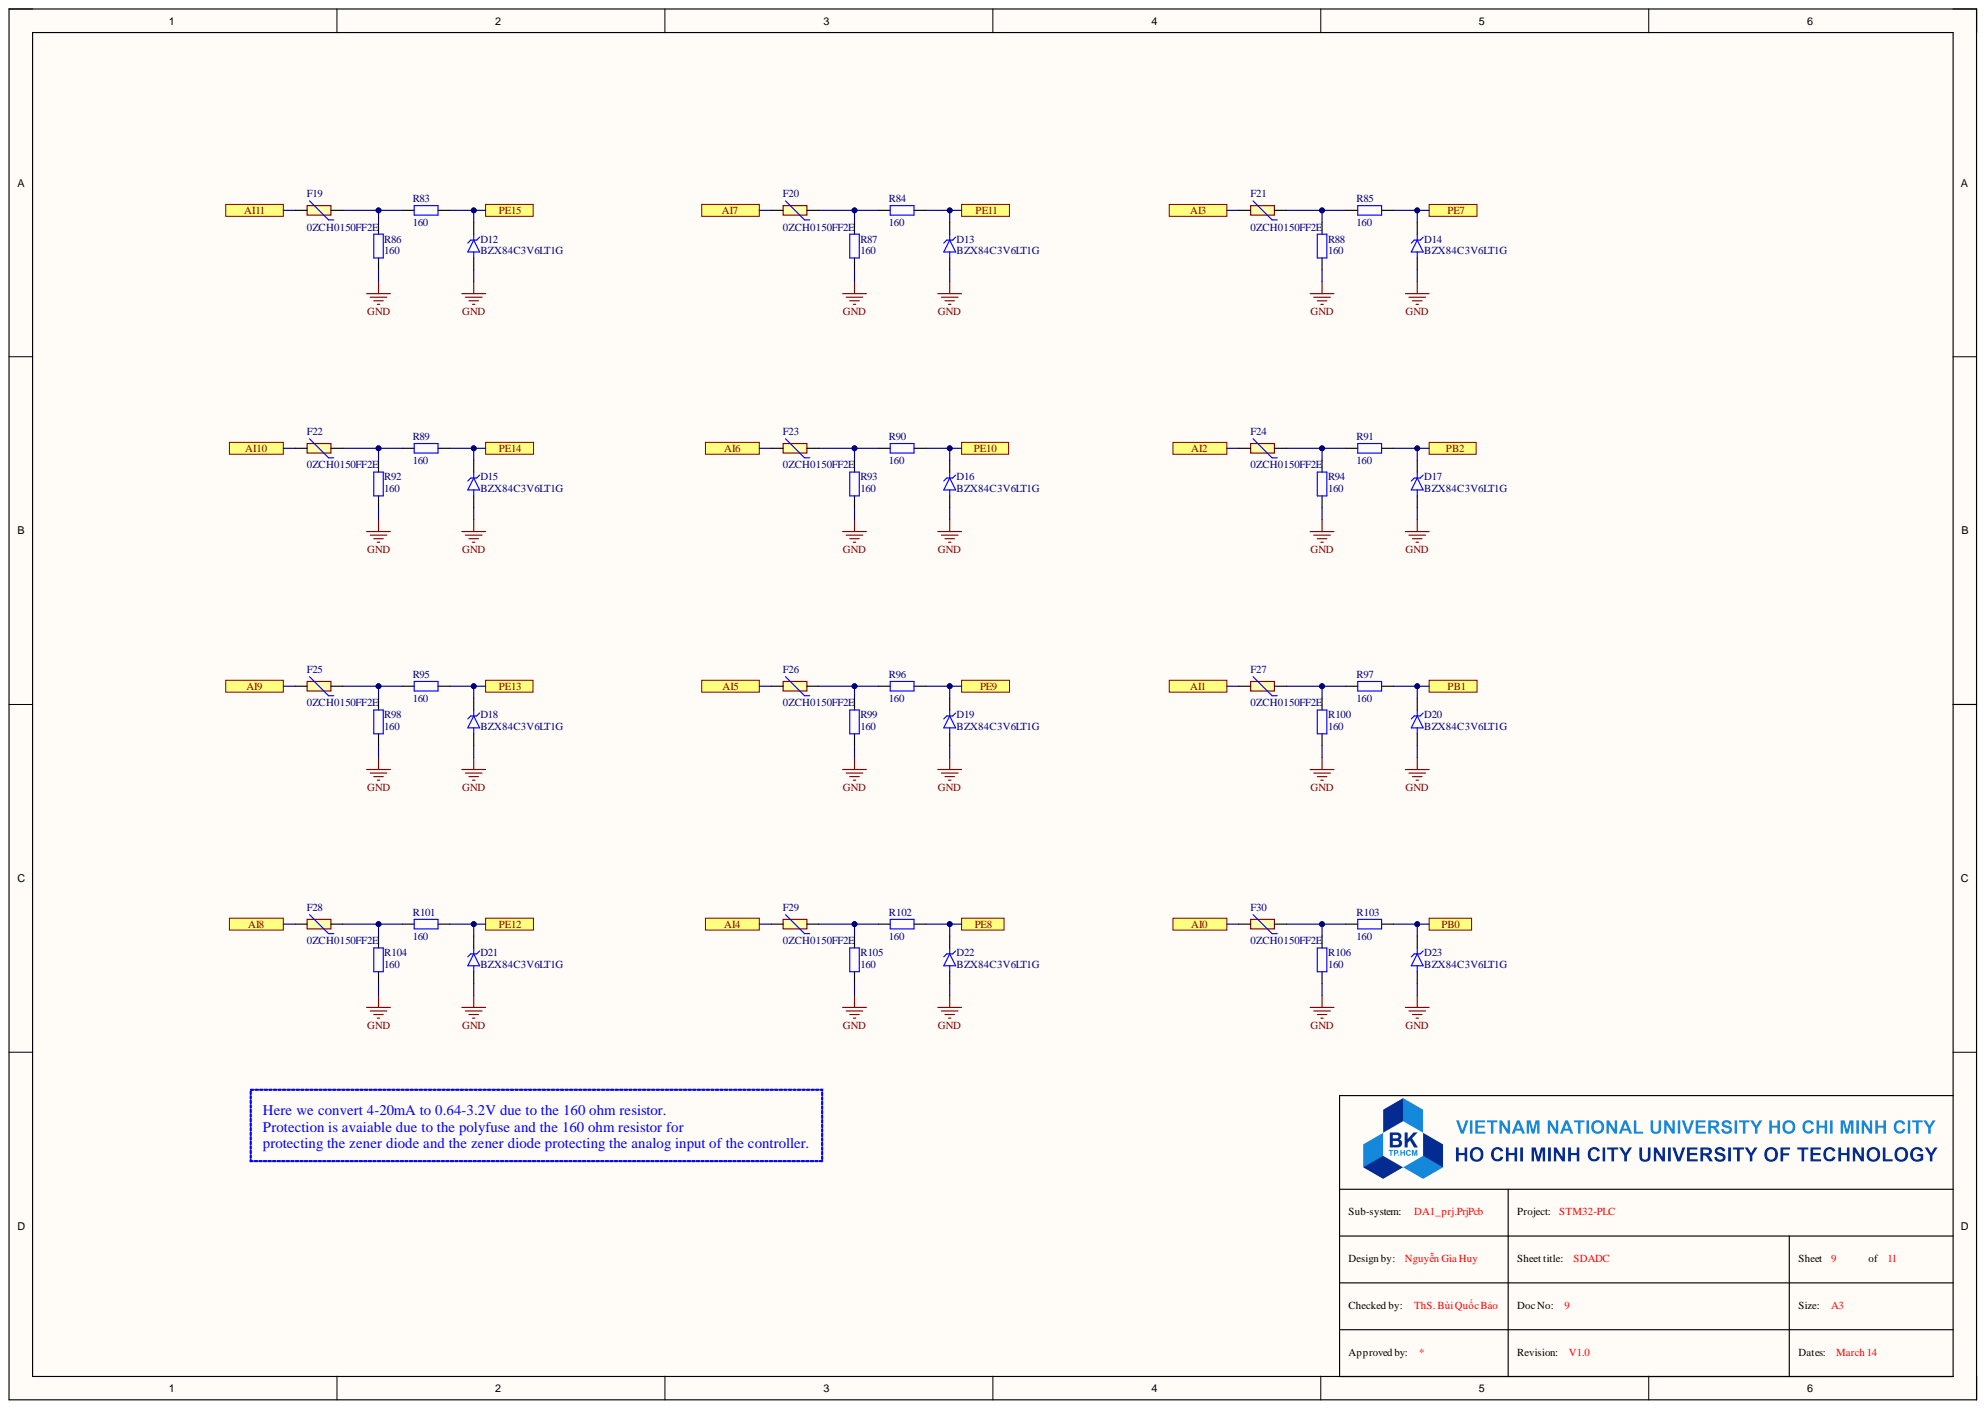
[picture p55: page 9]

Here we convert 4-20mA to 0.64-3.2V due to the 160 ohm resistor.
Protection is avaiable due to the polyfuse and the 160 ohm resistor for
protecting the zener diode and the zener diode protecting the analog input of the controller.

Sub-system: DA1_prj.PrjPcb | Project: STM32-PLC

Design by: Nguyễn Gia Huy | Sheet title: SDADC | Sheet 9 of 11

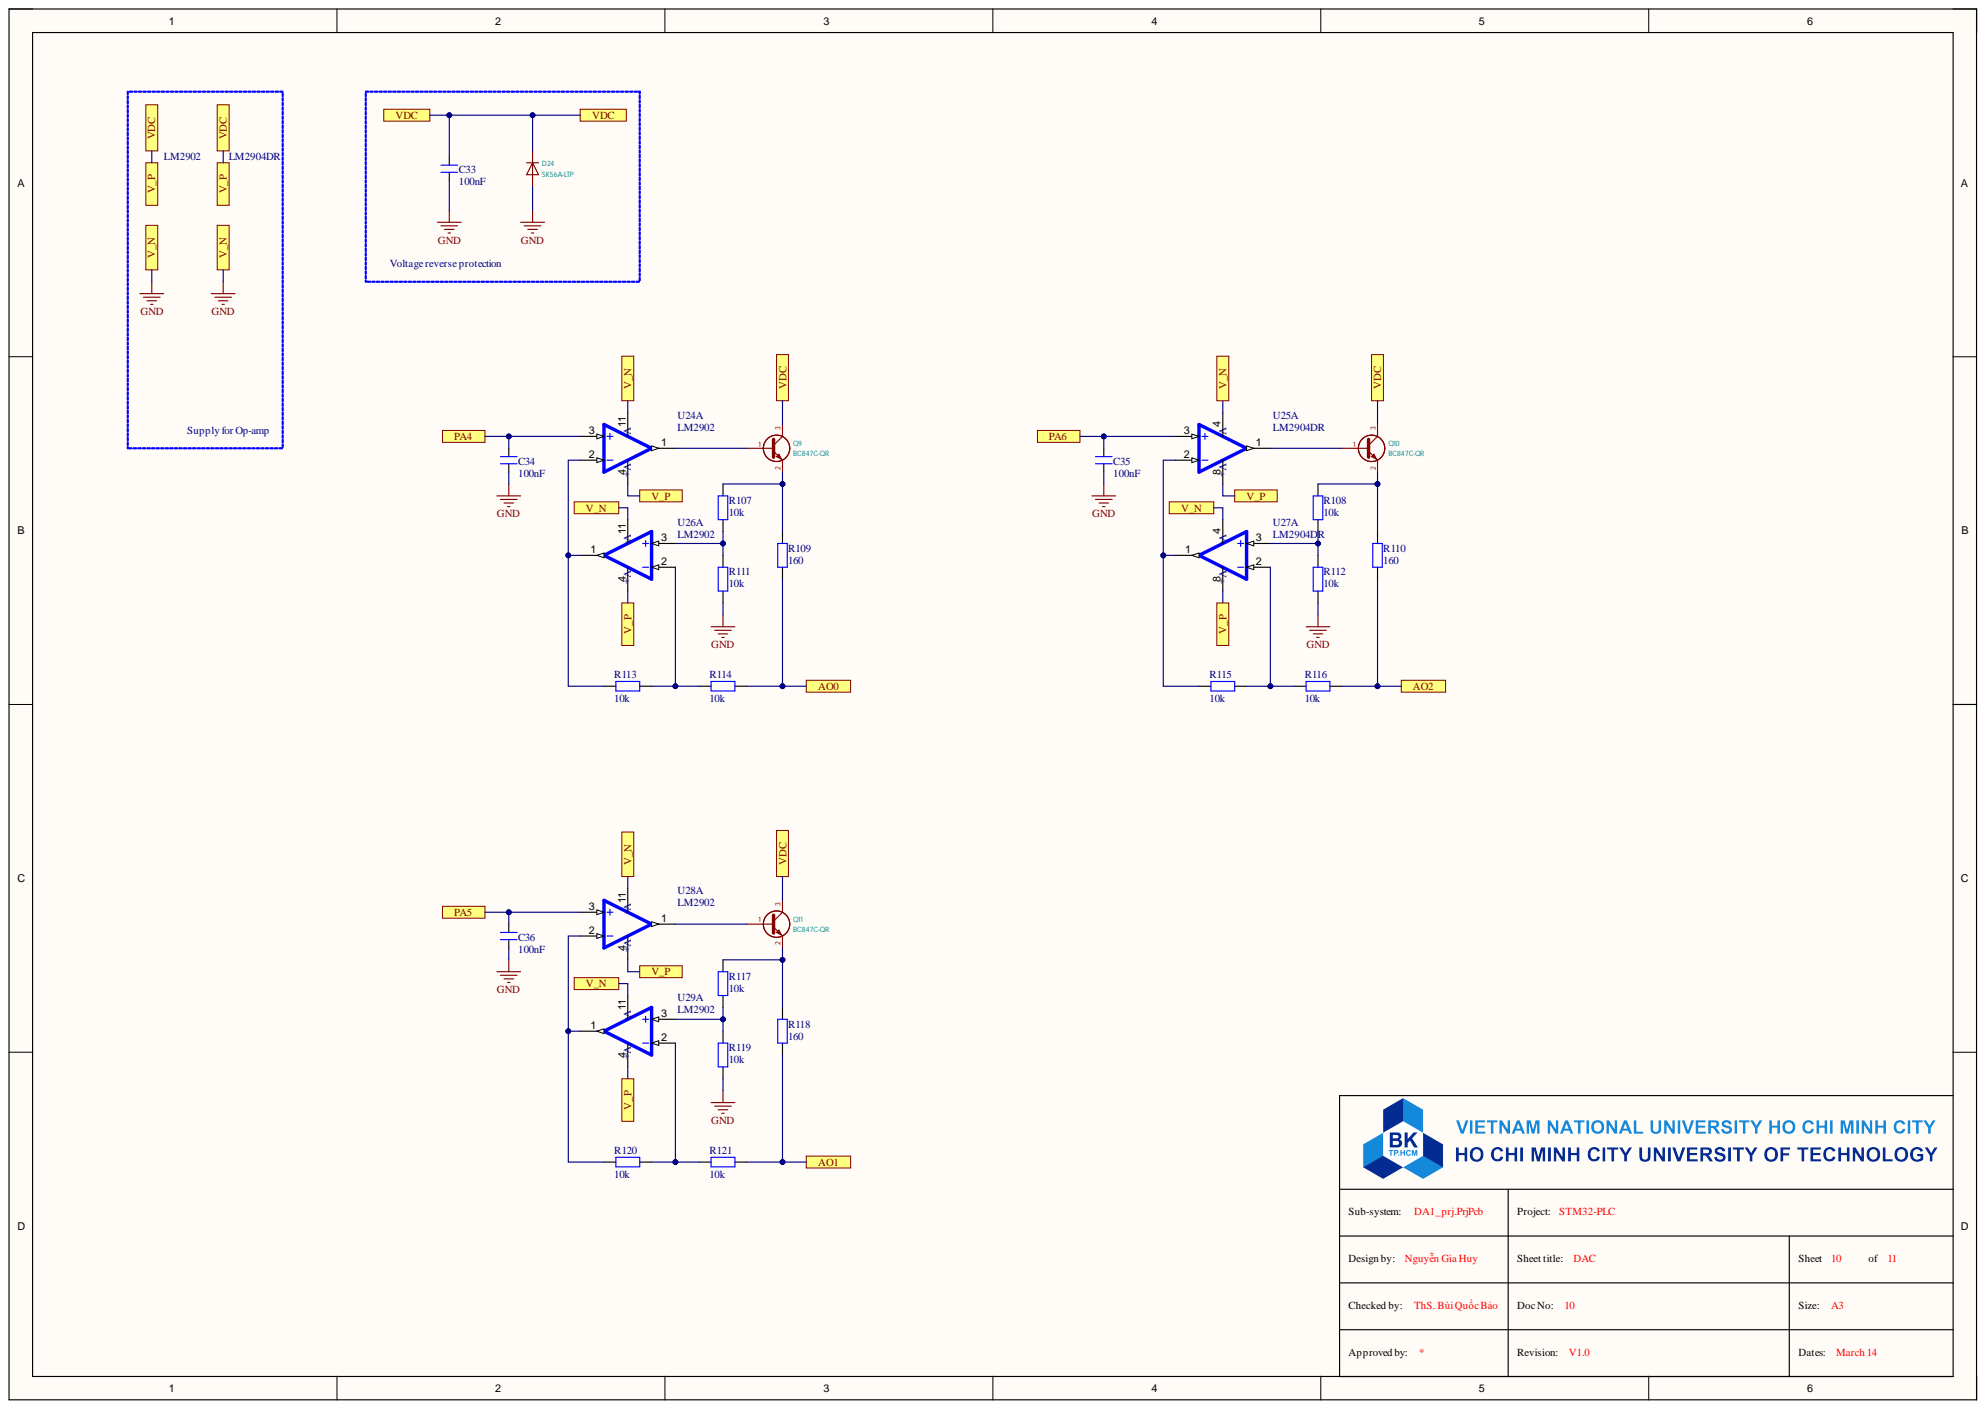
[picture p56: page 10]

Supply for Op-amp

Sub-system: DA1_prj.PrjPcb | Project: STM32-PLC

Design by: Nguyễn Gia Huy | Sheet title: DAC | Sheet 10 of 11

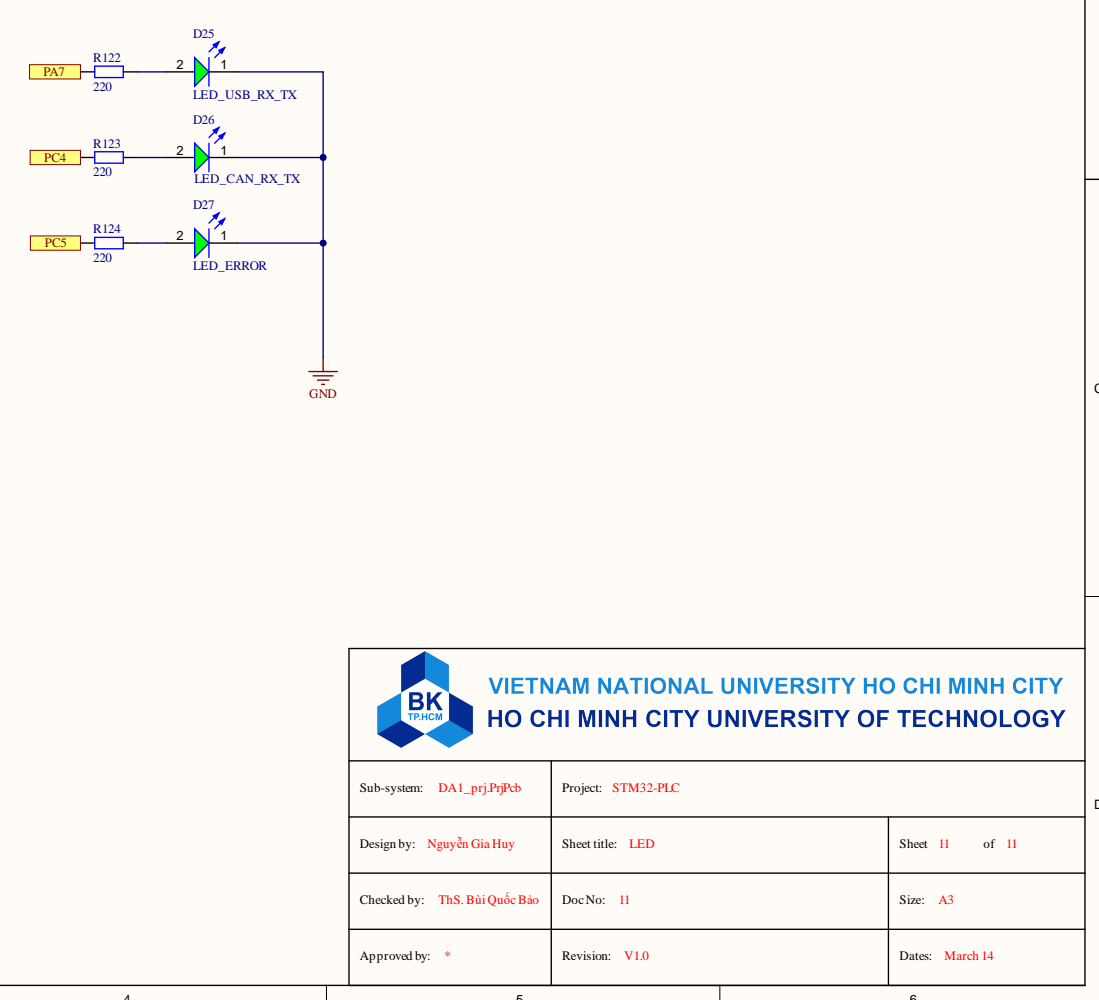
[picture p57: page 11]
LED_USB_RX_TX; LED_CAN_RX_TX; LED_ERROR; GND

Sub-system: DA1_prj.PrjPcb | Project: STM32-PLC

Design by: Nguyễn Gia Huy | Sheet title: LED | Sheet 11 of 11
