huynguyen2311179-ui/STM32-PLC/03_Simulation_Result/SDADC/SDADC.asc

D1: zener
I1: current; SINE(12m 15m 1)
R1: res; 160
R2: res; 160
R3: res; 1
Named nets: 0
.tran 3
