huynguyen2311179-ui/STM32-PLC/01_Full_Design/Simulate/DAC/DAC.asc

C1: cap; 100nF
Q1: npn
R1: res; 10k
R2: res; 10k
R3: res; 10k
R4: res; 10k
R5: res; 160
U1: UniversalOpAmp
U2: UniversalOpAmp
V1: voltage; 24
V2: voltage; 1
V3: voltage; 24
V4: voltage; 24
Named nets: 0
.dc V2 0.64 3.2 0.01
