huynguyen2311179-ui/STM32-PLC/01_Full_Design/Simulate/DAC/Draft1.asc

A1: schmtinv; Vhigh=3.3V Vlow=0V
Q1: WL-OCPT_Series_817
R1: res; 1k
R2: res; 1k
V1: voltage; 3.3V
V2: voltage; PULSE(0 5 0 1u 1u 0.5m 1m)
Named nets: 0
.tran 2m
