huynguyen2311179-ui/STM32-PLC/01_Full_Design/Simulate/SDADC/SDADC.asc

D1: zener
I1: current; SINE(12m 15m 1)
R1: res; 160
R2: res; 160
R4: res2; R = if(abs(I(R4)) > 30m, 1G, 0.1)
Named nets: 0
.tran 3
