huynguyen2311179-ui/STM32-PLC/(list of files, drawings)

Other design files:
01_Full_Design/CAN.SchDoc
01_Full_Design/COVER PAGE.SchDoc
01_Full_Design/DA1_prj1/connectors.PcbLib
01_Full_Design/DA1_prj1/DA1_prj.SCHLIB
01_Full_Design/DA1_prj1/PCB1.PcbLib
01_Full_Design/DA1_prj.PrjPcb
01_Full_Design/DAC.SchDoc
01_Full_Design/DIGTITAL.SchDoc
01_Full_Design/DSDADC.SchDoc
01_Full_Design/INDEX.SchDoc
01_Full_Design/INPUT.SchDoc
01_Full_Design/LED.SchDoc
01_Full_Design/PCB1.PcbDoc
01_Full_Design/PULSE.SchDoc
01_Full_Design/SDADC.SchDoc
01_Full_Design/Simulate/Digital/Digital.pdsprj
01_Full_Design/Simulate/Digital/Project Backups/Digital [20260427, 23-49-33].pdsprj
01_Full_Design/Simulate/Digital/Project Backups/Digital [20260427, 23-49-40].pdsprj
01_Full_Design/Simulate/INPUT/Input.pdsprj
01_Full_Design/Simulate/INPUT/Project Backups/Input [20260424, 13-32-15].pdsprj
01_Full_Design/Simulate/INPUT/Project Backups/Input [20260424, 14-06-04].pdsprj
01_Full_Design/Simulate/INPUT/Project Backups/Input [20260424, 14-18-23].pdsprj
01_Full_Design/Simulate/INPUT/Project Backups/Input [20260427, 05-38-07].pdsprj
01_Full_Design/STM32_PLC.SchDoc
03_Simulation_Result/Digital/Digital.pdsprj
03_Simulation_Result/Digital/Project Backups/Digital [20260427, 23-49-33].pdsprj
03_Simulation_Result/Digital/Project Backups/Digital [20260427, 23-49-40].pdsprj
03_Simulation_Result/INPUT/Input.pdsprj
03_Simulation_Result/INPUT/Project Backups/Input [20260424, 13-32-15].pdsprj
03_Simulation_Result/INPUT/Project Backups/Input [20260424, 14-06-04].pdsprj
03_Simulation_Result/INPUT/Project Backups/Input [20260424, 14-18-23].pdsprj
03_Simulation_Result/INPUT/Project Backups/Input [20260427, 05-38-07].pdsprj
